BlockWorker/EE-8BitComputer/main.brd

## EAGLE design main.brd (2024-01-15)

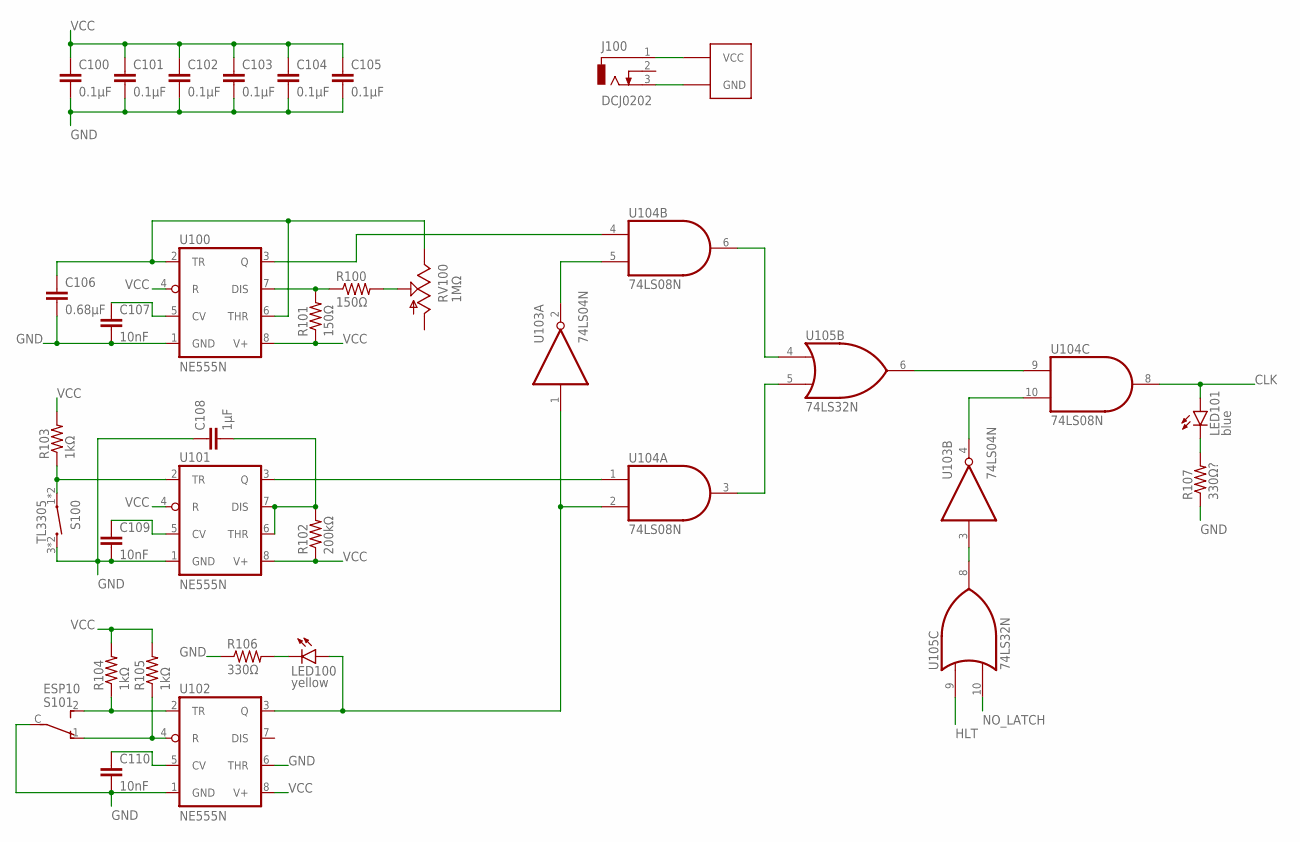
[picture p1: schematic main.sch, sheet 1, Clock & Power]

Parts:
C100, C101, C102, C103, C104, C105: 0.1µF; C0805K
C106: 0.68µF; C0805K
C107, C109, C110: 10nF; C0805K
C108: 1µF; C0805K
J100: DCJ0202
LED100: yellow; LED3MM
LED101: blue; LED3MM
R100, R101: 150Ω; R0805
R102: 200kΩ; R0805
R103, R104, R105: 1kΩ; R0805
R106: 330Ω; R0805
R107: 330Ω?; R0805
RV100: 1MΩ; CA9V
S100: TL3305; TL3305_MICROSWITCH
S101: ESP10
U100, U101, U102: NE555N; DIL08
U103: 74LS04N; DIL14
U104: 74LS08N; DIL14
U105: 74LS32N; DIL14

Connections:
!CLK_ENABLE: U103.3 (I), U105.8 (O)
!CLK_SWITCH: U103.2 (O), U104.5 (I1)
CLK: LED101.A, U104.8 (O); also elsewhere on the board
CLK_AUTO: U104.6 (O), U105.4 (I0)
CLK_AUTO_RAW: U100.3 (Q), U104.4 (I0)
CLK_ENABLE: U103.4 (O), U104.10 (I1)
CLK_MANUAL: U104.3 (O), U105.5 (I1)
CLK_MANUAL_RAW: U101.3 (Q), U104.1 (I0)
CLK_RAW: U104.9 (I0), U105.6 (O)
CLK_SWITCH: LED100.A, U102.3 (Q), U103.1 (I), U104.2 (I1)
GND: C100.2, C101.2, C102.2, C103.2, C104.2, C105.2, C106.2, C107.2, C108.1, C109.2, C110.2, J100.3, R106.1, R107.1, S100.3 (2), S100.4 (2), S101.C, U100.1 (GND), U101.1 (GND), U102.1 (GND), U102.6 (THR), U103.7 (GND), U104.7 (GND), U105.7 (GND); also elsewhere on the board
HLT: U105.9 (I0); also elsewhere on the board
LED100_GND: LED100.K (C), R106.2
LED101_GND: LED101.K (C), R107.2
NO_LATCH: U105.10 (I1); also elsewhere on the board
U100_CAP: C106.1, RV100.E, U100.2 (TR), U100.6 (THR)
U100_CV: C107.1, U100.5 (CV)
U100_DIS: R100.1, R101.2, U100.7 (DIS)
U100_DIS_INT: R100.2, RV100.S
U101_CAP: C108.2, R102.2, U101.6 (THR), U101.7 (DIS)
U101_CV: C109.1, U101.5 (CV)
U101_TR: R103.1, S100.1, S100.2 (1), U101.2 (TR)
U102_CV: C110.1, U102.5 (CV)
U102_R: R105.1, S101.1 (O), U102.4 (R)
U102_TR: R104.1, S101.2 (S), U102.2 (TR)
VCC: C100.1, C101.1, C102.1, C103.1, C104.1, C105.1, J100.1, R101.1, R102.1, R103.2, R104.2, R105.2, U100.4 (R), U100.8 (V+), U101.4 (R), U101.8 (V+), U102.8 (V+), U103.14 (VCC), U104.14 (VCC), U105.14 (VCC); also elsewhere on the board

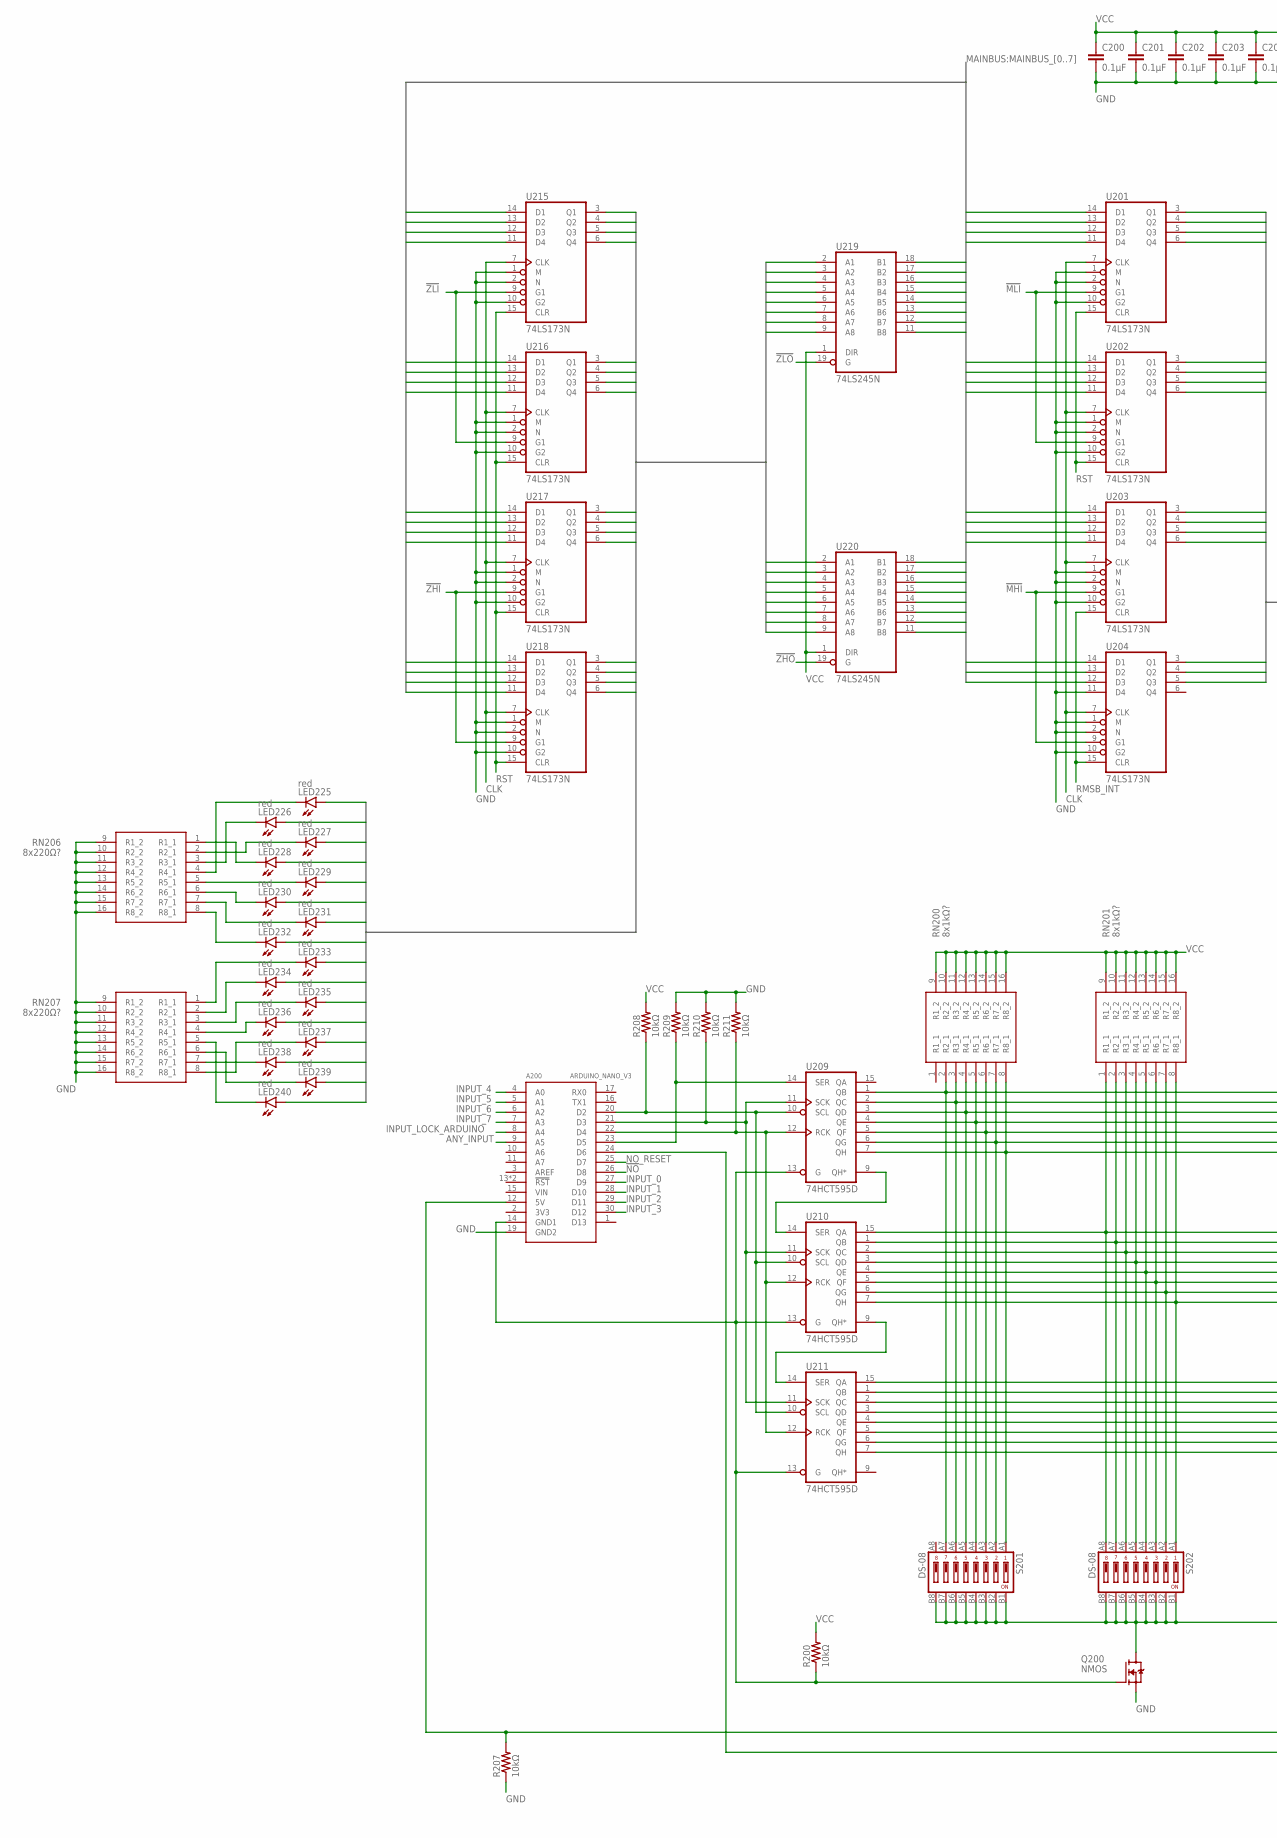
[picture p2: schematic main.sch, sheet 2, RAM & Z Register, part in row 1, column 1]

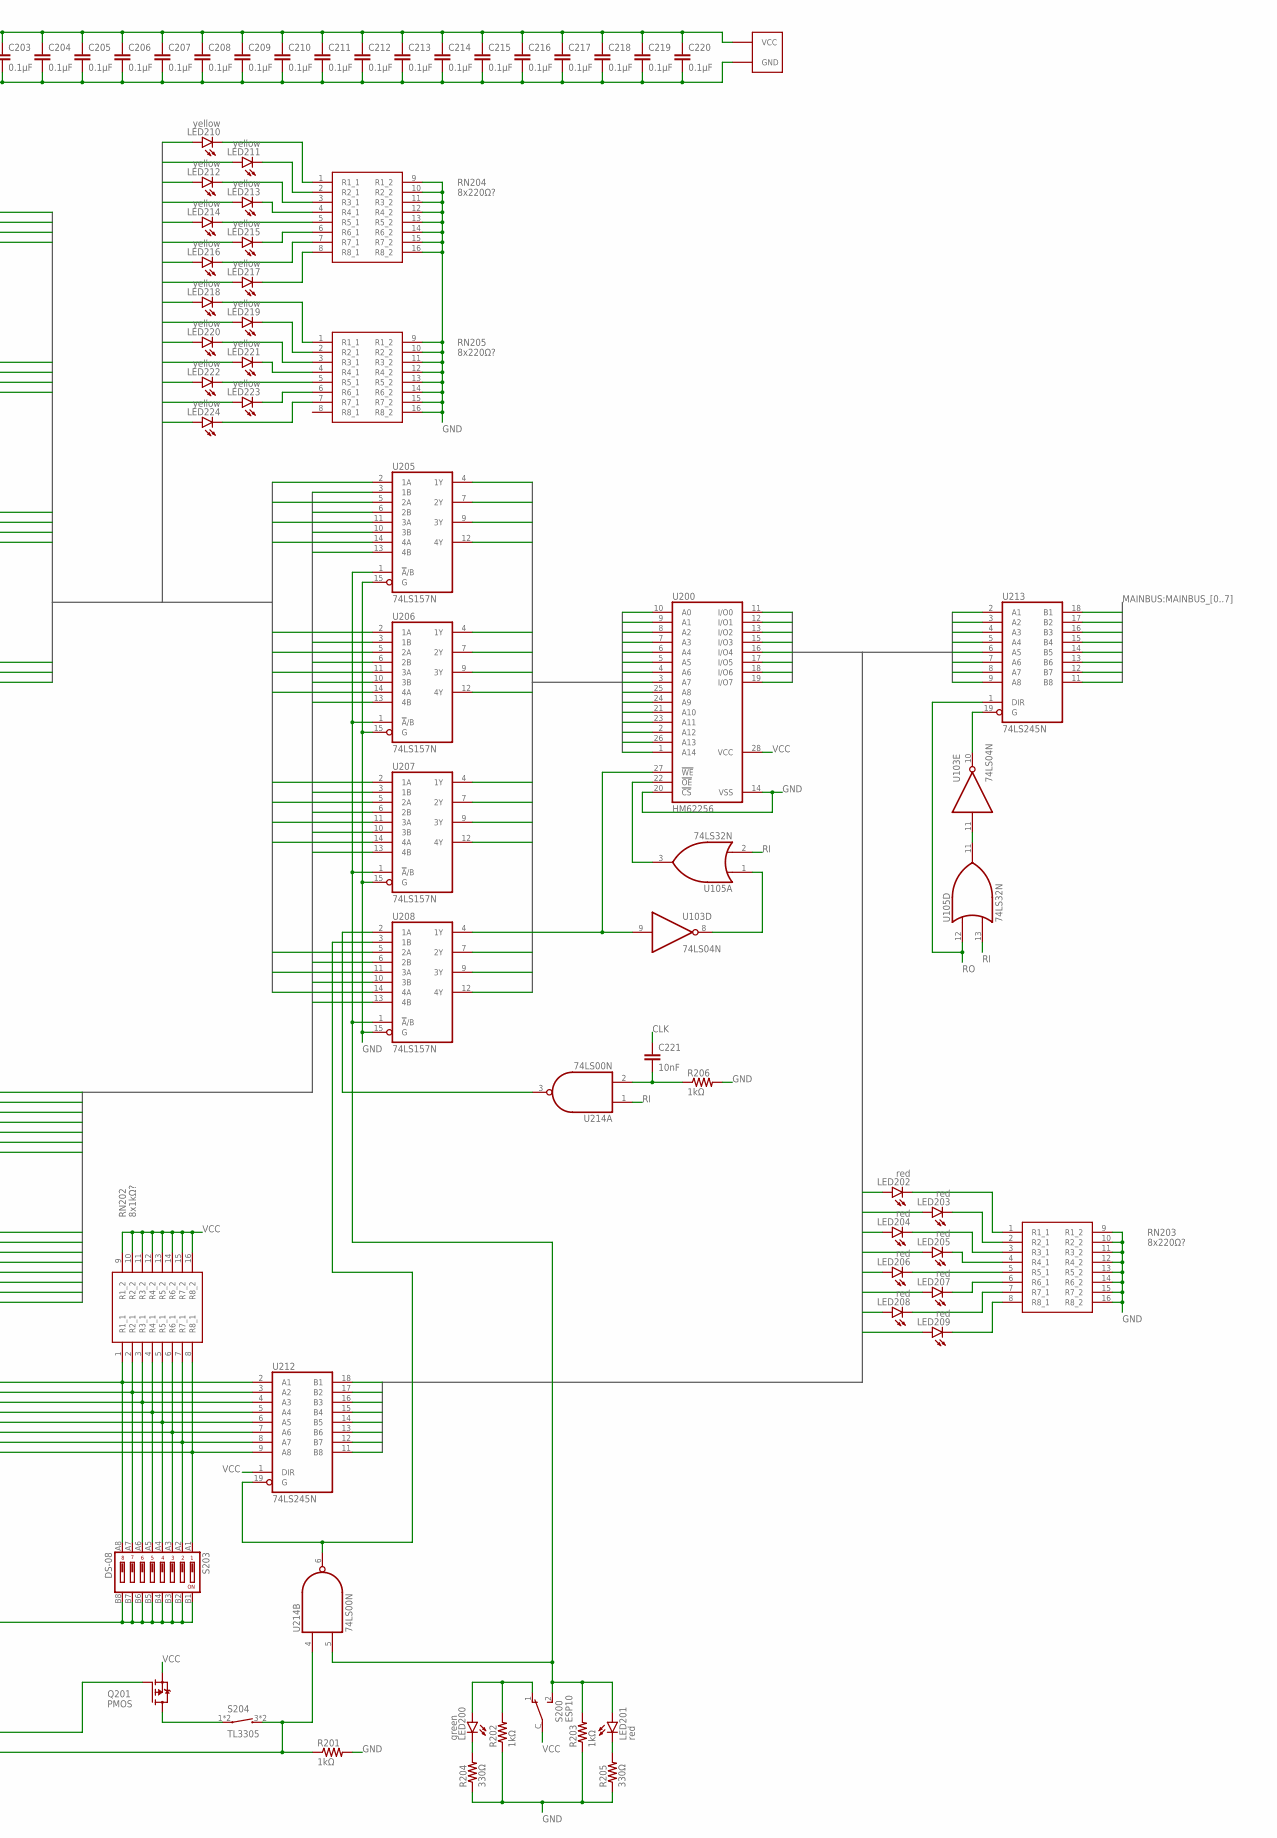
[picture p3: schematic main.sch, sheet 2, RAM & Z Register, part in row 1, column 2]

Parts:
A200: ARDUINO_NANO_V3
C200, C201, C202, C203, C204, C205, C206, C207, C208, C209, C210, C211, C212, C213, C214, C215, C216, C217, C218, C219, C220: 0.1µF; C0805K
C221: 10nF; C0805K
LED200: green; LED3MM
LED201, LED202, LED203, LED204, LED205, LED206, LED207, LED208, LED209, LED225, LED226, LED227, LED228, LED229, LED230, LED231, LED232, LED233, LED234, LED235, LED236, LED237, LED238, LED239, LED240: red; LED3MM
LED210, LED211, LED212, LED213, LED214, LED215, LED216, LED217, LED218, LED219, LED220, LED221, LED222, LED223, LED224: yellow; LED3MM
Q200: NMOS; SOT23
Q201: PMOS; SOT23
R200, R207, R208, R209, R210, R211: 10kΩ; R0805
R201, R202, R203, R206: 1kΩ; R0805
R204, R205: 330Ω; R0805
RN200, RN201, RN202: 8x1kΩ?; CAY16102J8LF
RN203, RN204, RN205, RN206, RN207: 8x220Ω?; CAY16102J8LF
S200: ESP10
S201, S202, S203: DS-08; DIPSW-08
S204: TL3305; TL3305_MICROSWITCH
U103: 74LS04N; DIL14
U105: 74LS32N; DIL14
U200: HM62256; DIL28-6
U201, U202, U203, U204, U215, U216, U217, U218: 74LS173N; DIL16
U205, U206, U207, U208: 74LS157N; DIL16
U209, U210, U211: 74HCT595D; SO16
U212, U213, U219, U220: 74LS245N; DIL20
U214: 74LS00N; DIL14

Connections:
!MEM_IO_EN: U103.10 (O), U213.19 (G)
!MEM_MANMODE: LED200.A, R202.2, S200.1 (O)
!MHI: U203.9 (G1), U204.9 (G1); also elsewhere on the board
!MLI: U201.9 (G1), U202.9 (G1); also elsewhere on the board
!NO: A200.26 (D8); also elsewhere on the board
!ZHI: U217.9 (G1), U218.9 (G1); also elsewhere on the board
!ZHO: U220.19 (G); also elsewhere on the board
!ZLI: U215.9 (G1), U216.9 (G1); also elsewhere on the board
!ZLO: U219.19 (G); also elsewhere on the board
ANY_INPUT: A200.9 (A5); also elsewhere on the board
ARDUINO_5V_SENSE: A200.12 (5V), Q201.1 (G), R207.2
ARDUINO_DETECT_GND: A200.14 (GND1), Q200.1 (G), R200.1, U209.13 (G), U210.13 (G), U211.13 (G)
ARDUINO_SR_CHAIN1: U209.9 (QH*), U210.14 (SER)
ARDUINO_SR_CHAIN2: U210.9 (QH*), U211.14 (SER)
ARDUINO_SR_CLK: A200.21 (D3), R210.1, U209.11 (SCK), U210.11 (SCK), U211.11 (SCK)
ARDUINO_SR_CLR: A200.20 (D2), R208.1, U209.10 (SCL), U210.10 (SCL), U211.10 (SCL)
ARDUINO_SR_DATA: A200.23 (D5), R209.1, U209.14 (SER)
ARDUINO_SR_PUSH: A200.22 (D4), R211.1, U209.12 (RCK), U210.12 (RCK), U211.12 (RCK)
CLK: C221.1, U201.7 (CLK), U202.7 (CLK), U203.7 (CLK), U204.7 (CLK), U215.7 (CLK), U216.7 (CLK), U217.7 (CLK), U218.7 (CLK); also elsewhere on the board
GND: A200.19 (GND2), C200.2, C201.2, C202.2, C203.2, C204.2, C205.2, C206.2, C207.2, C208.2, C209.2, C210.2, C211.2, C212.2, C213.2, C214.2, C215.2, C216.2, C217.2, C218.2, C219.2, C220.2, Q200.2 (S), R201.2, R202.1, R203.1, R204.1, R205.1, R206.2, R207.1, R209.2, R210.2, R211.2, RN203.9 (R1_2), RN203.10 (R2_2), RN203.11 (R3_2), RN203.12 (R4_2), RN203.13 (R5_2), RN203.14 (R6_2), RN203.15 (R7_2), RN203.16 (R8_2), RN204.9 (R1_2), RN204.10 (R2_2), RN204.11 (R3_2), RN204.12 (R4_2), RN204.13 (R5_2), RN204.14 (R6_2), RN204.15 (R7_2), RN204.16 (R8_2), RN205.9 (R1_2), RN205.10 (R2_2), RN205.11 (R3_2), RN205.12 (R4_2), RN205.13 (R5_2), RN205.14 (R6_2), RN205.15 (R7_2), RN205.16 (R8_2), RN206.9 (R1_2), RN206.10 (R2_2), RN206.11 (R3_2), RN206.12 (R4_2), RN206.13 (R5_2), RN206.14 (R6_2), RN206.15 (R7_2), RN206.16 (R8_2), RN207.9 (R1_2), RN207.10 (R2_2), RN207.11 (R3_2), RN207.12 (R4_2), RN207.13 (R5_2), RN207.14 (R6_2), RN207.15 (R7_2), RN207.16 (R8_2), U103.7 (GND), U105.7 (GND), U200.14 (VSS), U200.20 (!CS), U201.1 (M), U201.2 (N), U201.8 (GND), U201.10 (G2), U202.1 (M), U202.2 (N), U202.8 (GND), U202.10 (G2), U203.1 (M), U203.2 (N), U203.8 (GND), U203.10 (G2), U204.1 (M), U204.2 (N), U204.8 (GND), U204.10 (G2), U204.11 (D4), U205.8 (GND), U205.15 (G), U206.8 (GND), U206.15 (G), U207.8 (GND), U207.15 (G), U208.8 (GND), U208.15 (G), U209.8 (GND), U210.8 (GND), U211.8 (GND), U212.10 (GND), U213.10 (GND), U214.7 (GND), U215.1 (M), U215.2 (N), U215.8 (GND), U215.10 (G2), U216.1 (M), U216.2 (N), U216.8 (GND), U216.10 (G2), U217.1 (M), U217.2 (N), U217.8 (GND), U217.10 (G2), U218.1 (M), U218.2 (N), U218.8 (GND), U218.10 (G2), U219.10 (GND), U220.10 (GND); also elsewhere on the board
INPUT_0: A200.27 (D9); also elsewhere on the board
INPUT_1: A200.28 (D10); also elsewhere on the board
INPUT_2: A200.29 (D11); also elsewhere on the board
INPUT_3: A200.30 (D12); also elsewhere on the board
INPUT_4: A200.4 (A0); also elsewhere on the board
INPUT_5: A200.5 (A1); also elsewhere on the board
INPUT_6: A200.6 (A2); also elsewhere on the board
INPUT_7: A200.7 (A3); also elsewhere on the board
INPUT_LOCK_ARDUINO: A200.8 (A4); also elsewhere on the board
LED202_GND: LED202.K (C), RN203.1 (R1_1)
LED203_GND: LED203.K (C), RN203.2 (R2_1)
LED204_GND: LED204.K (C), RN203.3 (R3_1)
LED205_GND: LED205.K (C), RN203.4 (R4_1)
LED206_GND: LED206.K (C), RN203.5 (R5_1)
LED207_GND: LED207.K (C), RN203.6 (R6_1)
LED208_GND: LED208.K (C), RN203.7 (R7_1)
LED209_GND: LED209.K (C), RN203.8 (R8_1)
LED210_GND: LED210.K (C), RN204.1 (R1_1)
LED211_GND: LED211.K (C), RN204.2 (R2_1)
LED212_GND: LED212.K (C), RN204.3 (R3_1)
LED213_GND: LED213.K (C), RN204.4 (R4_1)
LED214_GND: LED214.K (C), RN204.5 (R5_1)
LED215_GND: LED215.K (C), RN204.6 (R6_1)
LED216_GND: LED216.K (C), RN204.7 (R7_1)
LED217_GND: LED217.K (C), RN204.8 (R8_1)
LED218_GND: LED218.K (C), RN205.1 (R1_1)
LED219_GND: LED219.K (C), RN205.2 (R2_1)
LED220_GND: LED220.K (C), RN205.3 (R3_1)
LED221_GND: LED221.K (C), RN205.4 (R4_1)
LED222_GND: LED222.K (C), RN205.5 (R5_1)
LED223_GND: LED223.K (C), RN205.6 (R6_1)
LED224_GND: LED224.K (C), RN205.7 (R7_1)
LED225_GND: LED225.K (C), RN206.4 (R4_1)
LED226_GND: LED226.K (C), RN206.3 (R3_1)
LED227_GND: LED227.K (C), RN206.2 (R2_1)
LED228_GND: LED228.K (C), RN206.1 (R1_1)
LED229_GND: LED229.K (C), RN206.5 (R5_1)
LED230_GND: LED230.K (C), RN206.6 (R6_1)
LED231_GND: LED231.K (C), RN206.7 (R7_1)
LED232_GND: LED232.K (C), RN206.8 (R8_1)
LED233_GND: LED233.K (C), RN207.1 (R1_1)
LED234_GND: LED234.K (C), RN207.2 (R2_1)
LED235_GND: LED235.K (C), RN207.3 (R3_1)
LED236_GND: LED236.K (C), RN207.4 (R4_1)
LED237_GND: LED237.K (C), RN207.8 (R8_1)
LED238_GND: LED238.K (C), RN207.7 (R7_1)
LED239_GND: LED239.K (C), RN207.6 (R6_1)
LED240_GND: LED240.K (C), RN207.5 (R5_1)
MAINBUS_0: U201.14 (D1), U203.14 (D1), U213.18 (B1), U215.14 (D1), U217.14 (D1), U219.18 (B1), U220.18 (B1); also elsewhere on the board
MAINBUS_1: U201.13 (D2), U203.13 (D2), U213.17 (B2), U215.13 (D2), U217.13 (D2), U219.17 (B2), U220.17 (B2); also elsewhere on the board
MAINBUS_2: U201.12 (D3), U203.12 (D3), U213.16 (B3), U215.12 (D3), U217.12 (D3), U219.16 (B3), U220.16 (B3); also elsewhere on the board
MAINBUS_3: U201.11 (D4), U203.11 (D4), U213.15 (B4), U215.11 (D4), U217.11 (D4), U219.15 (B4), U220.15 (B4); also elsewhere on the board
MAINBUS_4: U202.14 (D1), U204.14 (D1), U213.14 (B5), U216.14 (D1), U218.14 (D1), U219.14 (B5), U220.14 (B5); also elsewhere on the board
MAINBUS_5: U202.13 (D2), U204.13 (D2), U213.13 (B6), U216.13 (D2), U218.13 (D2), U219.13 (B6), U220.13 (B6); also elsewhere on the board
MAINBUS_6: U202.12 (D3), U204.12 (D3), U213.12 (B7), U216.12 (D3), U218.12 (D3), U219.12 (B7), U220.12 (B7); also elsewhere on the board
MAINBUS_7: U202.11 (D4), U213.11 (B8), U216.11 (D4), U218.11 (D4), U219.11 (B8), U220.11 (B8); also elsewhere on the board
MEMADDR_0: U200.10 (A0), U205.4 (1Y)
MEMADDR_1: U200.9 (A1), U205.7 (2Y)
MEMADDR_2: U200.8 (A2), U205.12 (4Y)
MEMADDR_3: U200.7 (A3), U205.9 (3Y)
MEMADDR_4: U200.6 (A4), U206.7 (2Y)
MEMADDR_5: U200.5 (A5), U206.4 (1Y)
MEMADDR_6: U200.4 (A6), U206.9 (3Y)
MEMADDR_7: U200.3 (A7), U206.12 (4Y)
MEMADDR_8: U200.25 (A8), U207.7 (2Y)
MEMADDR_9: U200.24 (A9), U207.4 (1Y)
MEMADDR_10: U200.21 (A10), U207.12 (4Y)
MEMADDR_11: U200.23 (A11), U207.9 (3Y)
MEMADDR_12: U200.2 (A12), U208.12 (4Y)
MEMADDR_13: U200.26 (A13), U208.7 (2Y)
MEMADDR_14: U200.1 (A14), U208.9 (3Y)
MEMADDR_AUTO_0: LED210.A, U201.3 (Q1), U205.2 (1A)
MEMADDR_AUTO_1: LED211.A, U201.4 (Q2), U205.5 (2A)
MEMADDR_AUTO_2: LED212.A, U201.5 (Q3), U205.14 (4A)
MEMADDR_AUTO_3: LED213.A, U201.6 (Q4), U205.11 (3A)
MEMADDR_AUTO_4: LED214.A, U202.3 (Q1), U206.5 (2A)
MEMADDR_AUTO_5: LED215.A, U202.4 (Q2), U206.2 (1A)
MEMADDR_AUTO_6: LED216.A, U202.5 (Q3), U206.11 (3A)
MEMADDR_AUTO_7: LED217.A, U202.6 (Q4), U206.14 (4A)
MEMADDR_AUTO_8: LED218.A, U203.3 (Q1), U207.5 (2A)
MEMADDR_AUTO_9: LED219.A, U203.4 (Q2), U207.2 (1A)
MEMADDR_AUTO_10: LED220.A, U203.5 (Q3), U207.14 (4A)
MEMADDR_AUTO_11: LED221.A, U203.6 (Q4), U207.11 (3A)
MEMADDR_AUTO_12: LED222.A, U204.3 (Q1), U208.14 (4A)
MEMADDR_AUTO_13: LED223.A, U204.4 (Q2), U208.5 (2A)
MEMADDR_AUTO_14: LED224.A, U204.5 (Q3), U208.11 (3A)
MEMADDR_MAN_0: RN201.8 (R8_1), S202.A1 (1), U205.3 (1B), U210.7 (QH)
MEMADDR_MAN_1: RN201.7 (R7_1), S202.A2 (2), U205.6 (2B), U210.6 (QG)
MEMADDR_MAN_2: RN201.6 (R6_1), S202.A3 (3), U205.13 (4B), U210.5 (QF)
MEMADDR_MAN_3: RN201.5 (R5_1), S202.A4 (4), U205.10 (3B), U210.4 (QE)
MEMADDR_MAN_4: RN201.4 (R4_1), S202.A5 (5), U206.6 (2B), U210.3 (QD)
MEMADDR_MAN_5: RN201.3 (R3_1), S202.A6 (6), U206.3 (1B), U210.2 (QC)
MEMADDR_MAN_6: RN201.2 (R2_1), S202.A7 (7), U206.10 (3B), U210.1 (QB)
MEMADDR_MAN_7: RN201.1 (R1_1), S202.A8 (8), U206.13 (4B), U210.15 (QA)
MEMADDR_MAN_8: RN200.8 (R8_1), S201.A1 (1), U207.6 (2B), U209.7 (QH)
MEMADDR_MAN_9: RN200.7 (R7_1), S201.A2 (2), U207.3 (1B), U209.6 (QG)
MEMADDR_MAN_10: RN200.6 (R6_1), S201.A3 (3), U207.13 (4B), U209.5 (QF)
MEMADDR_MAN_11: RN200.5 (R5_1), S201.A4 (4), U207.10 (3B), U209.4 (QE)
MEMADDR_MAN_12: RN200.4 (R4_1), S201.A5 (5), U208.13 (4B), U209.3 (QD)
MEMADDR_MAN_13: RN200.3 (R3_1), S201.A6 (6), U208.6 (2B), U209.2 (QC)
MEMADDR_MAN_14: RN200.2 (R2_1), S201.A7 (7), U208.10 (3B), U209.1 (QB)
MEMIO_0: LED202.A, U200.11 (I/O0), U212.11 (B8), U213.2 (A1)
MEMIO_1: LED203.A, U200.12 (I/O1), U212.12 (B7), U213.3 (A2)
MEMIO_2: LED204.A, U200.13 (I/O2), U212.13 (B6), U213.4 (A3)
MEMIO_3: LED205.A, U200.15 (I/O3), U212.14 (B5), U213.5 (A4)
MEMIO_4: LED206.A, U200.16 (I/O4), U212.15 (B4), U213.6 (A5)
MEMIO_5: LED207.A, U200.17 (I/O5), U212.16 (B3), U213.7 (A6)
MEMIO_6: LED208.A, U200.18 (I/O6), U212.17 (B2), U213.8 (A7)
MEMIO_7: LED209.A, U200.19 (I/O7), U212.18 (B1), U213.9 (A8)
MEMIO_MAN_0: RN202.8 (R8_1), S203.A1 (1), U211.7 (QH), U212.9 (A8)
MEMIO_MAN_1: RN202.7 (R7_1), S203.A2 (2), U211.6 (QG), U212.8 (A7)
MEMIO_MAN_2: RN202.6 (R6_1), S203.A3 (3), U211.5 (QF), U212.7 (A6)
MEMIO_MAN_3: RN202.5 (R5_1), S203.A4 (4), U211.4 (QE), U212.6 (A5)
MEMIO_MAN_4: RN202.4 (R4_1), S203.A5 (5), U211.3 (QD), U212.5 (A4)
MEMIO_MAN_5: RN202.3 (R3_1), S203.A6 (6), U211.2 (QC), U212.4 (A3)
MEMIO_MAN_6: RN202.2 (R2_1), S203.A7 (7), U211.1 (QB), U212.3 (A2)
MEMIO_MAN_7: RN202.1 (R1_1), S203.A8 (8), U211.15 (QA), U212.2 (A1)
MEM_!MANMODE!_LED: LED200.K (C), R204.2
MEM_!OE: U105.3 (O), U200.22 (!OE)
MEM_!OE_INT: U103.8 (O), U105.1 (I0)
MEM_!WE: U103.9 (I), U200.27 (!WE), U208.4 (1Y)
MEM_!WE!_AUTO: U208.2 (1A), U214.3 (O)
MEM_!WE!_MAN: U208.3 (1B), U212.19 (G), U214.6 (O)
MEM_CLK_PULSE: C221.2, R206.1, U214.2 (I1)
MEM_IO_EN: U103.11 (I), U105.11 (O)
MEM_MANMODE: LED201.A, R203.2, S200.2 (S), U205.1 (!A!/B), U206.1 (!A!/B), U207.1 (!A!/B), U208.1 (!A!/B), U214.5 (I1)
MEM_MANMODE_LED: LED201.K (C), R205.2
MEM_MAN_GND: Q200.3 (D), S201.B1 (16), S201.B2 (15), S201.B3 (14), S201.B4 (13), S201.B5 (12), S201.B6 (11), S201.B7 (10), S201.B8 (9), S202.B1 (16), S202.B2 (15), S202.B3 (14), S202.B4 (13), S202.B5 (12), S202.B6 (11), S202.B7 (10), S202.B8 (9), S203.B1 (16), S203.B2 (15), S203.B3 (14), S203.B4 (13), S203.B5 (12), S203.B6 (11), S203.B7 (10), S203.B8 (9)
MEM_MAN_VCC: Q201.3 (D), S204.1, S204.2 (1)
MEM_MAN_WRITE: A200.24 (D6), R201.1, S204.3 (2), S204.4 (2), U214.4 (I0)
NO_RESET: A200.25 (D7); also elsewhere on the board
REG_Z_0: LED225.A, U215.3 (Q1), U219.2 (A1)
REG_Z_1: LED226.A, U215.4 (Q2), U219.3 (A2)
REG_Z_2: LED227.A, U215.5 (Q3), U219.4 (A3)
REG_Z_3: LED228.A, U215.6 (Q4), U219.5 (A4)
REG_Z_4: LED229.A, U216.3 (Q1), U219.6 (A5)
REG_Z_5: LED230.A, U216.4 (Q2), U219.7 (A6)
REG_Z_6: LED231.A, U216.5 (Q3), U219.8 (A7)
REG_Z_7: LED232.A, U216.6 (Q4), U219.9 (A8)
REG_Z_8: LED233.A, U217.3 (Q1), U220.2 (A1)
REG_Z_9: LED234.A, U217.4 (Q2), U220.3 (A2)
REG_Z_10: LED235.A, U217.5 (Q3), U220.4 (A3)
REG_Z_11: LED236.A, U217.6 (Q4), U220.5 (A4)
REG_Z_12: LED237.A, U218.3 (Q1), U220.6 (A5)
REG_Z_13: LED238.A, U218.4 (Q2), U220.7 (A6)
REG_Z_14: LED239.A, U218.5 (Q3), U220.8 (A7)
REG_Z_15: LED240.A, U218.6 (Q4), U220.9 (A8)
RI: U105.2 (I1), U105.13 (I1), U214.1 (I0); also elsewhere on the board
RMSB_INT: U203.15 (CLR), U204.15 (CLR); also elsewhere on the board
RO: U105.12 (I0), U213.1 (DIR); also elsewhere on the board
RST: U201.15 (CLR), U202.15 (CLR), U215.15 (CLR), U216.15 (CLR), U217.15 (CLR), U218.15 (CLR); also elsewhere on the board
VCC: C200.1, C201.1, C202.1, C203.1, C204.1, C205.1, C206.1, C207.1, C208.1, C209.1, C210.1, C211.1, C212.1, C213.1, C214.1, C215.1, C216.1, C217.1, C218.1, C219.1, C220.1, Q201.2 (S), R200.2, R208.2, RN200.9 (R1_2), RN200.10 (R2_2), RN200.11 (R3_2), RN200.12 (R4_2), RN200.13 (R5_2), RN200.14 (R6_2), RN200.15 (R7_2), RN200.16 (R8_2), RN201.9 (R1_2), RN201.10 (R2_2), RN201.11 (R3_2), RN201.12 (R4_2), RN201.13 (R5_2), RN201.14 (R6_2), RN201.15 (R7_2), RN201.16 (R8_2), RN202.9 (R1_2), RN202.10 (R2_2), RN202.11 (R3_2), RN202.12 (R4_2), RN202.13 (R5_2), RN202.14 (R6_2), RN202.15 (R7_2), RN202.16 (R8_2), S200.C, U103.14 (VCC), U105.14 (VCC), U200.28 (VCC), U201.16 (VCC), U202.16 (VCC), U203.16 (VCC), U204.16 (VCC), U205.16 (VCC), U206.16 (VCC), U207.16 (VCC), U208.16 (VCC), U209.16 (VCC), U210.16 (VCC), U211.16 (VCC), U212.1 (DIR), U212.20 (VCC), U213.20 (VCC), U214.14 (VCC), U215.16 (VCC), U216.16 (VCC), U217.16 (VCC), U218.16 (VCC), U219.1 (DIR), U219.20 (VCC), U220.1 (DIR), U220.20 (VCC); also elsewhere on the board

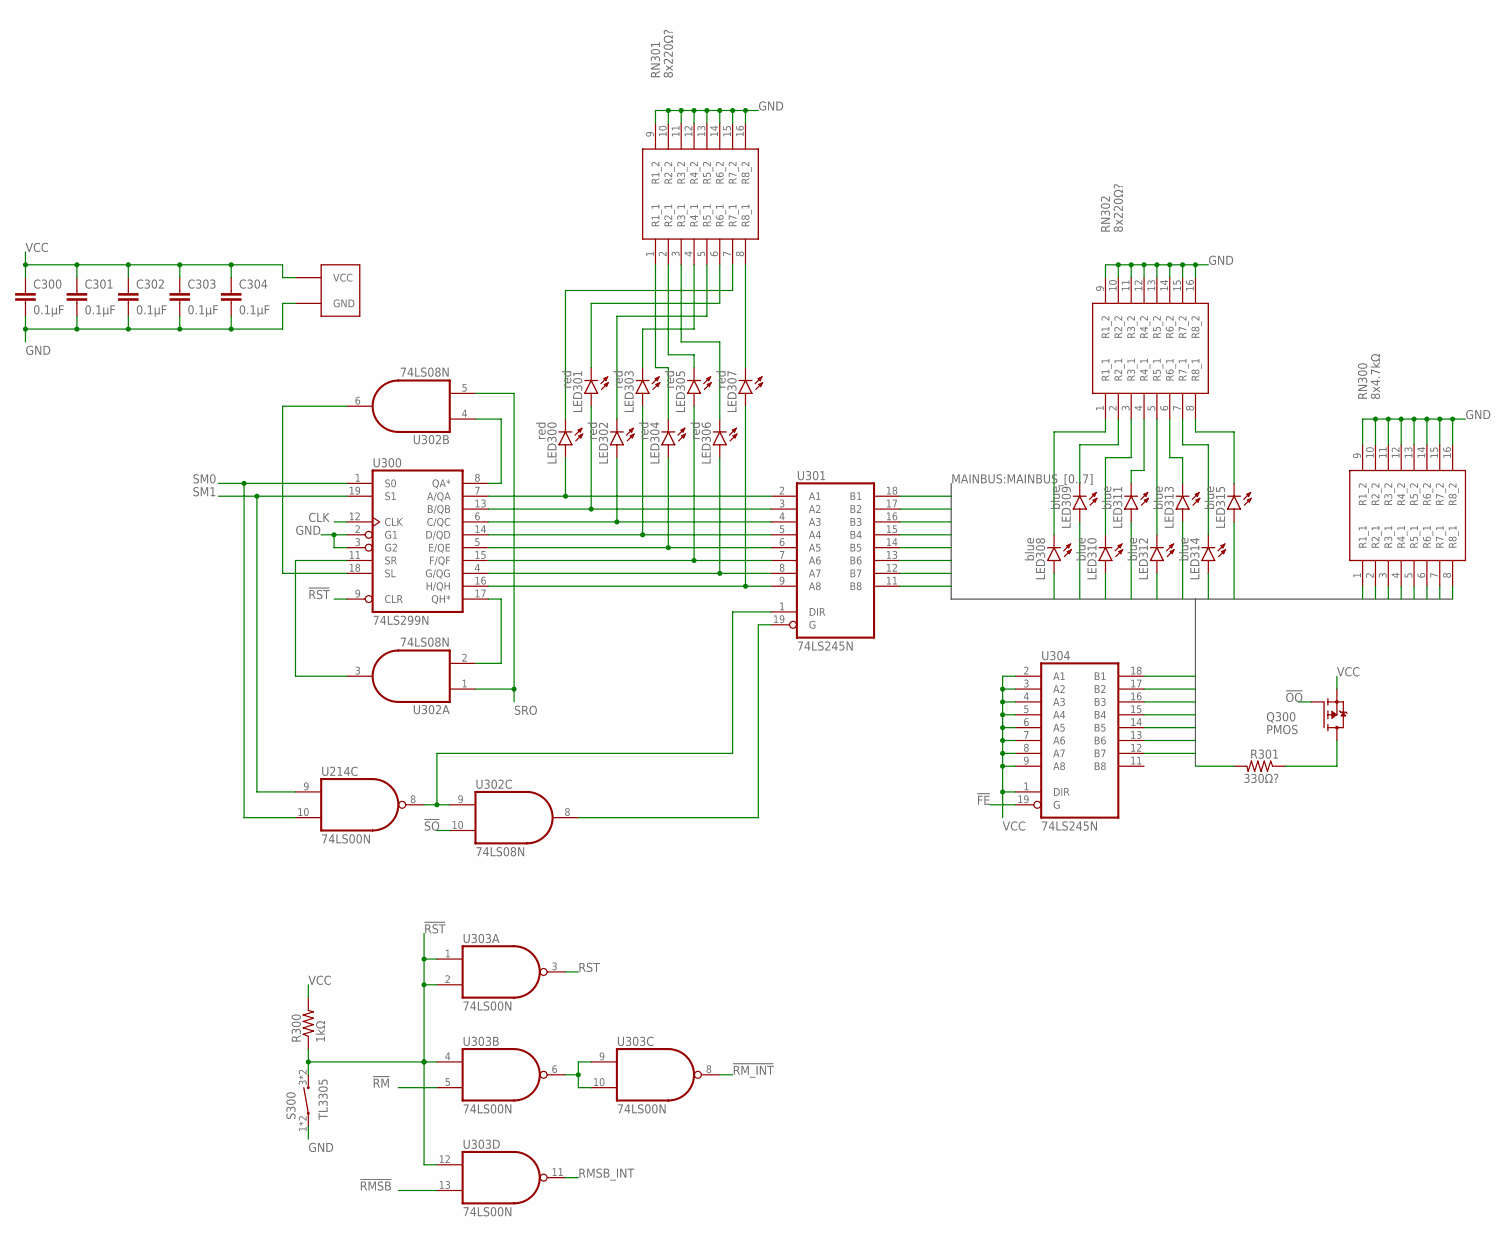
[picture p4: schematic main.sch, sheet 3, Shift Register, Bus & Reset]

Parts:
C300, C301, C302, C303, C304: 0.1µF; C0805K
LED300, LED301, LED302, LED303, LED304, LED305, LED306, LED307: red; LED3MM
LED308, LED309, LED310, LED311, LED312, LED313, LED314, LED315: blue; LED3MM
Q300: PMOS; SOT23
R300: 1kΩ; R0805
R301: 330Ω?; R0805
RN300: 8x4.7kΩ; CAY16102J8LF
RN301, RN302: 8x220Ω?; CAY16102J8LF
S300: TL3305; TL3305_MICROSWITCH
U214, U303: 74LS00N; DIL14
U300: 74LS299N; DIL20
U301, U304: 74LS245N; DIL20
U302: 74LS08N; DIL14

Connections:
!FE: U304.19 (G); also elsewhere on the board
!OO: Q300.1 (G); also elsewhere on the board
!RM: U303.5 (I1); also elsewhere on the board
!RMSB: U303.13 (I1); also elsewhere on the board
!RM_INT: U303.8 (O); also elsewhere on the board
!RST: R300.1, S300.3 (2), S300.4 (2), U300.9 (CLR), U303.1 (I0), U303.2 (I1), U303.4 (I0), U303.12 (I0); also elsewhere on the board
!SHIFT_IO_EN: U301.19 (G), U302.8 (O)
!SO: U302.10 (I1); also elsewhere on the board
BUS_OO: Q300.3 (D), R301.1
CLK: U300.12 (CLK); also elsewhere on the board
GND: C300.2, C301.2, C302.2, C303.2, C304.2, RN300.9 (R1_2), RN300.10 (R2_2), RN300.11 (R3_2), RN300.12 (R4_2), RN300.13 (R5_2), RN300.14 (R6_2), RN300.15 (R7_2), RN300.16 (R8_2), RN301.9 (R1_2), RN301.10 (R2_2), RN301.11 (R3_2), RN301.12 (R4_2), RN301.13 (R5_2), RN301.14 (R6_2), RN301.15 (R7_2), RN301.16 (R8_2), RN302.9 (R1_2), RN302.10 (R2_2), RN302.11 (R3_2), RN302.12 (R4_2), RN302.13 (R5_2), RN302.14 (R6_2), RN302.15 (R7_2), RN302.16 (R8_2), S300.1, S300.2 (1), U214.7 (GND), U300.2 (G1), U300.3 (G2), U300.10 (GND), U301.10 (GND), U302.7 (GND), U303.7 (GND), U304.10 (GND); also elsewhere on the board
LED300_GND: LED300.K (C), RN301.7 (R7_1)
LED301_GND: LED301.K (C), RN301.6 (R6_1)
LED302_GND: LED302.K (C), RN301.5 (R5_1)
LED303_GND: LED303.K (C), RN301.4 (R4_1)
LED304_GND: LED304.K (C), RN301.1 (R1_1)
LED305_GND: LED305.K (C), RN301.2 (R2_1)
LED306_GND: LED306.K (C), RN301.3 (R3_1)
LED307_GND: LED307.K (C), RN301.8 (R8_1)
LED308_GND: LED308.K (C), RN302.1 (R1_1)
LED309_GND: LED309.K (C), RN302.2 (R2_1)
LED310_GND: LED310.K (C), RN302.3 (R3_1)
LED311_GND: LED311.K (C), RN302.4 (R4_1)
LED312_GND: LED312.K (C), RN302.5 (R5_1)
LED313_GND: LED313.K (C), RN302.6 (R6_1)
LED314_GND: LED314.K (C), RN302.7 (R7_1)
LED315_GND: LED315.K (C), RN302.8 (R8_1)
MAINBUS_0: LED315.A, R301.2, RN300.8 (R8_1), U301.11 (B8); also elsewhere on the board
MAINBUS_1: LED314.A, RN300.7 (R7_1), U301.12 (B7), U304.12 (B7); also elsewhere on the board
MAINBUS_2: LED313.A, RN300.6 (R6_1), U301.13 (B6), U304.13 (B6); also elsewhere on the board
MAINBUS_3: LED312.A, RN300.5 (R5_1), U301.14 (B5), U304.14 (B5); also elsewhere on the board
MAINBUS_4: LED311.A, RN300.4 (R4_1), U301.15 (B4), U304.15 (B4); also elsewhere on the board
MAINBUS_5: LED310.A, RN300.3 (R3_1), U301.16 (B3), U304.16 (B3); also elsewhere on the board
MAINBUS_6: LED309.A, RN300.2 (R2_1), U301.17 (B2), U304.17 (B2); also elsewhere on the board
MAINBUS_7: LED308.A, RN300.1 (R1_1), U301.18 (B1), U304.18 (B1); also elsewhere on the board
RMSB_INT: U303.11 (O); also elsewhere on the board
RM_INT: U303.6 (O), U303.9 (I0), U303.10 (I1)
RST: U303.3 (O); also elsewhere on the board
SHIFT_IO_0: LED307.A, U300.16 (H/QH), U301.9 (A8)
SHIFT_IO_1: LED306.A, U300.4 (G/QG), U301.8 (A7)
SHIFT_IO_2: LED305.A, U300.15 (F/QF), U301.7 (A6)
SHIFT_IO_3: LED304.A, U300.5 (E/QE), U301.6 (A5)
SHIFT_IO_4: LED303.A, U300.14 (D/QD), U301.5 (A4)
SHIFT_IO_5: LED302.A, U300.6 (C/QC), U301.4 (A3)
SHIFT_IO_6: LED301.A, U300.13 (B/QB), U301.3 (A2)
SHIFT_IO_7: LED300.A, U300.7 (A/QA), U301.2 (A1)
SHIFT_IO_DIR: U214.8 (O), U301.1 (DIR), U302.9 (I0)
SHIFT_LEFT_FEEDBACK: U300.18 (SL), U302.6 (O)
SHIFT_LEFT_FEEDBACK_RAW: U300.8 (QA*), U302.4 (I0)
SHIFT_RIGHT_FEEDBACK: U300.11 (SR), U302.3 (O)
SHIFT_RIGHT_FEEDBACK_RAW: U300.17 (QH*), U302.2 (I1)
SM0: U214.10 (I1), U300.1 (S0); also elsewhere on the board
SM1: U214.9 (I0), U300.19 (S1); also elsewhere on the board
SRO: U302.1 (I0), U302.5 (I1); also elsewhere on the board
VCC: C300.1, C301.1, C302.1, C303.1, C304.1, Q300.2 (S), R300.2, U214.14 (VCC), U300.20 (VCC), U301.20 (VCC), U302.14 (VCC), U303.14 (VCC), U304.1 (DIR), U304.2 (A1), U304.3 (A2), U304.4 (A3), U304.5 (A4), U304.6 (A5), U304.7 (A6), U304.8 (A7), U304.9 (A8), U304.20 (VCC); also elsewhere on the board

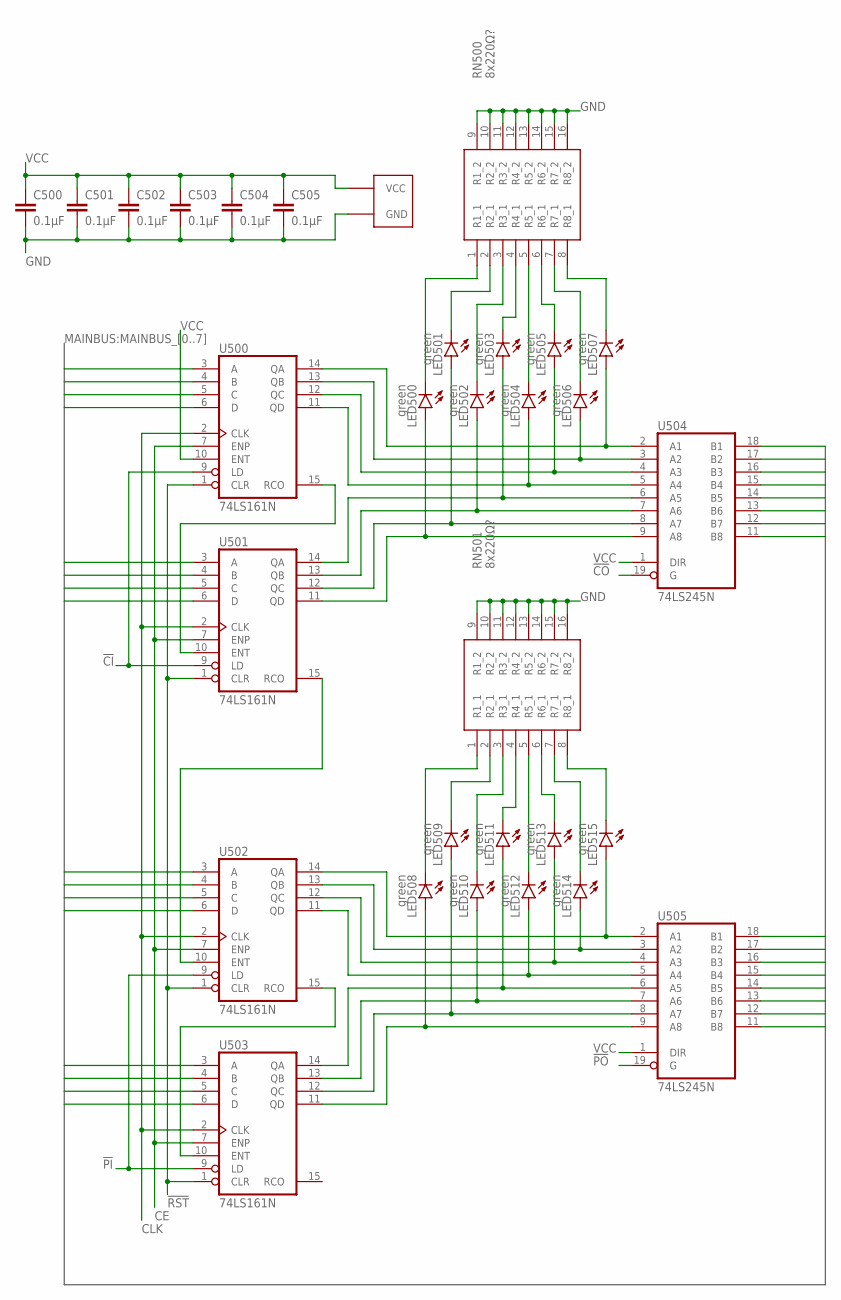
[picture p5: schematic main.sch, sheet 4, Program Counter]

Parts:
C500, C501, C502, C503, C504, C505: 0.1µF; C0805K
LED500, LED501, LED502, LED503, LED504, LED505, LED506, LED507, LED508, LED509, LED510, LED511, LED512, LED513, LED514, LED515: green; LED3MM
RN500, RN501: 8x220Ω?; CAY16102J8LF
U500, U501, U502, U503: 74LS161N; DIL16
U504, U505: 74LS245N; DIL20

Connections:
!CI: U500.9 (LD), U501.9 (LD); also elsewhere on the board
!CO: U504.19 (G); also elsewhere on the board
!PI: U502.9 (LD), U503.9 (LD); also elsewhere on the board
!PO: U505.19 (G); also elsewhere on the board
!RST: U500.1 (CLR), U501.1 (CLR), U502.1 (CLR), U503.1 (CLR); also elsewhere on the board
CE: U500.7 (ENP), U501.7 (ENP), U502.7 (ENP), U503.7 (ENP); also elsewhere on the board
CLK: U500.2 (CLK), U501.2 (CLK), U502.2 (CLK), U503.2 (CLK); also elsewhere on the board
COUNTER_0: LED507.A, U500.14 (QA), U504.2 (A1)
COUNTER_1: LED506.A, U500.13 (QB), U504.3 (A2)
COUNTER_2: LED505.A, U500.12 (QC), U504.4 (A3)
COUNTER_3: LED504.A, U500.11 (QD), U504.5 (A4)
COUNTER_4: LED503.A, U501.14 (QA), U504.6 (A5)
COUNTER_5: LED502.A, U501.13 (QB), U504.7 (A6)
COUNTER_6: LED501.A, U501.12 (QC), U504.8 (A7)
COUNTER_7: LED500.A, U501.11 (QD), U504.9 (A8)
COUNTER_RIPPLE_1: U500.15 (RCO), U501.10 (ENT)
COUNTER_RIPPLE_2: U501.15 (RCO), U502.10 (ENT)
COUNTER_RIPPLE_3: U502.15 (RCO), U503.10 (ENT)
GND: C500.2, C501.2, C502.2, C503.2, C504.2, C505.2, RN500.9 (R1_2), RN500.10 (R2_2), RN500.11 (R3_2), RN500.12 (R4_2), RN500.13 (R5_2), RN500.14 (R6_2), RN500.15 (R7_2), RN500.16 (R8_2), RN501.9 (R1_2), RN501.10 (R2_2), RN501.11 (R3_2), RN501.12 (R4_2), RN501.13 (R5_2), RN501.14 (R6_2), RN501.15 (R7_2), RN501.16 (R8_2), U500.8 (GND), U501.8 (GND), U502.8 (GND), U503.8 (GND), U504.10 (GND), U505.10 (GND); also elsewhere on the board
LED500_GND: LED500.K (C), RN500.1 (R1_1)
LED501_GND: LED501.K (C), RN500.2 (R2_1)
LED502_GND: LED502.K (C), RN500.3 (R3_1)
LED503_GND: LED503.K (C), RN500.4 (R4_1)
LED504_GND: LED504.K (C), RN500.5 (R5_1)
LED505_GND: LED505.K (C), RN500.6 (R6_1)
LED506_GND: LED506.K (C), RN500.7 (R7_1)
LED507_GND: LED507.K (C), RN500.8 (R8_1)
LED508_GND: LED508.K (C), RN501.1 (R1_1)
LED509_GND: LED509.K (C), RN501.2 (R2_1)
LED510_GND: LED510.K (C), RN501.3 (R3_1)
LED511_GND: LED511.K (C), RN501.4 (R4_1)
LED512_GND: LED512.K (C), RN501.5 (R5_1)
LED513_GND: LED513.K (C), RN501.6 (R6_1)
LED514_GND: LED514.K (C), RN501.7 (R7_1)
LED515_GND: LED515.K (C), RN501.8 (R8_1)
MAINBUS_0: U500.3 (A), U502.3 (A), U504.18 (B1), U505.18 (B1); also elsewhere on the board
MAINBUS_1: U500.4 (B), U502.4 (B), U504.17 (B2), U505.17 (B2); also elsewhere on the board
MAINBUS_2: U500.5 (C), U502.5 (C), U504.16 (B3), U505.16 (B3); also elsewhere on the board
MAINBUS_3: U500.6 (D), U502.6 (D), U504.15 (B4), U505.15 (B4); also elsewhere on the board
MAINBUS_4: U501.3 (A), U503.3 (A), U504.14 (B5), U505.14 (B5); also elsewhere on the board
MAINBUS_5: U501.4 (B), U503.4 (B), U504.13 (B6), U505.13 (B6); also elsewhere on the board
MAINBUS_6: U501.5 (C), U503.5 (C), U504.12 (B7), U505.12 (B7); also elsewhere on the board
MAINBUS_7: U501.6 (D), U503.6 (D), U504.11 (B8), U505.11 (B8); also elsewhere on the board
PAGE_0: LED515.A, U502.14 (QA), U505.2 (A1)
PAGE_1: LED514.A, U502.13 (QB), U505.3 (A2)
PAGE_2: LED513.A, U502.12 (QC), U505.4 (A3)
PAGE_3: LED512.A, U502.11 (QD), U505.5 (A4)
PAGE_4: LED511.A, U503.14 (QA), U505.6 (A5)
PAGE_5: LED510.A, U503.13 (QB), U505.7 (A6)
PAGE_6: LED509.A, U503.12 (QC), U505.8 (A7)
PAGE_7: LED508.A, U503.11 (QD), U505.9 (A8)
VCC: C500.1, C501.1, C502.1, C503.1, C504.1, C505.1, U500.10 (ENT), U500.16 (VCC), U501.16 (VCC), U502.16 (VCC), U503.16 (VCC), U504.1 (DIR), U504.20 (VCC), U505.1 (DIR), U505.20 (VCC); also elsewhere on the board
