BlockWorker/EE-8BitComputer/main.brd

## EAGLE design main.brd (continued)

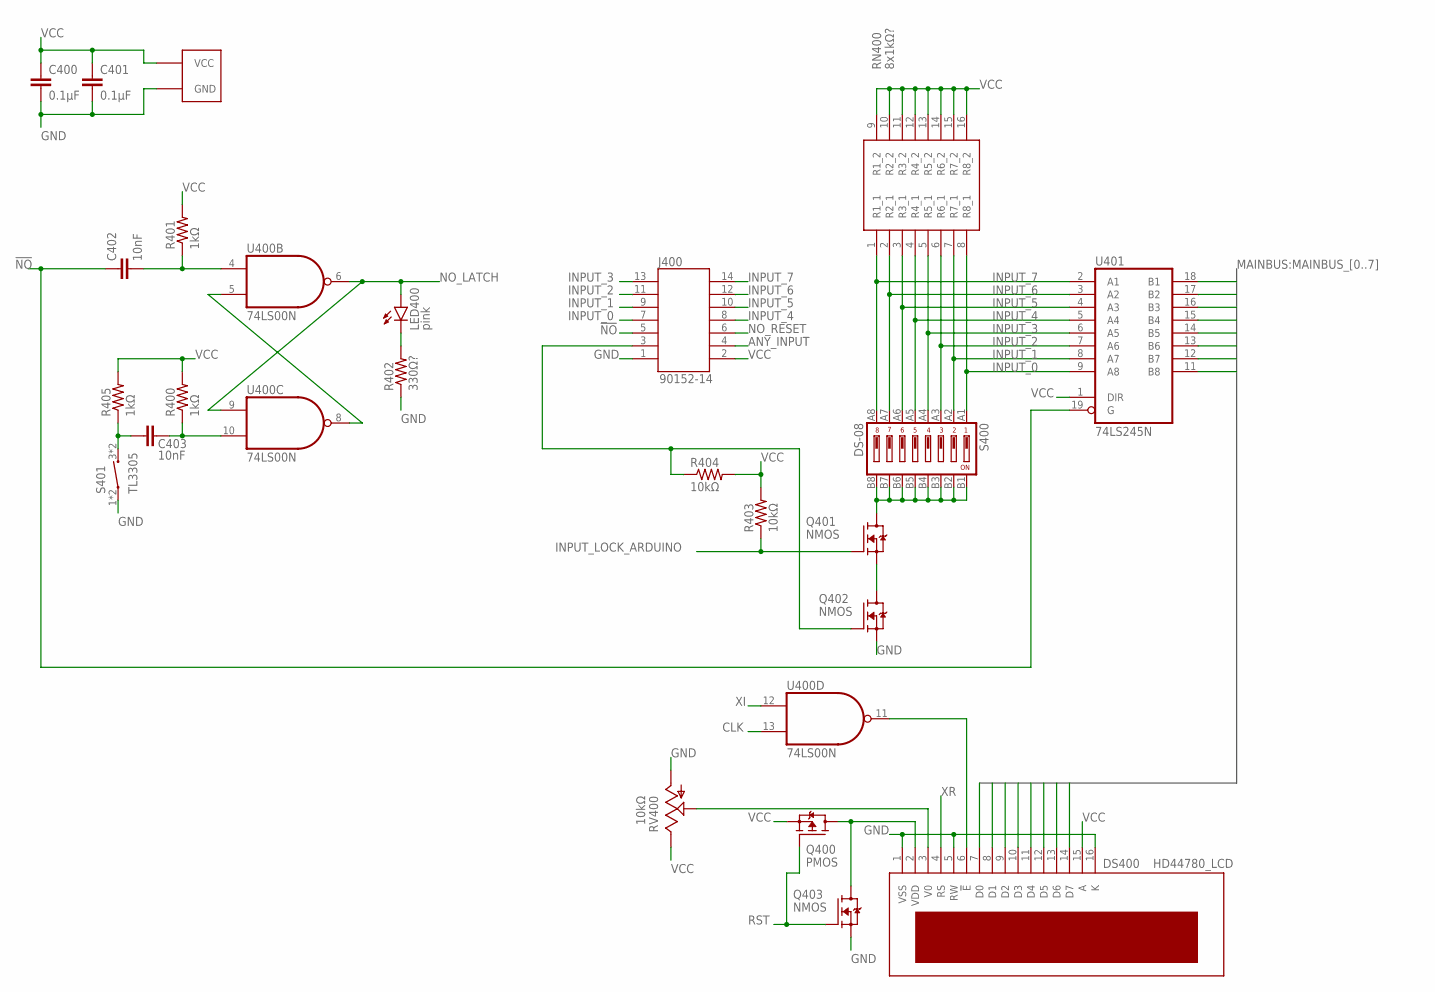
[picture p6: schematic main.sch, sheet 5, User Input & LCD]

Parts:
C400, C401: 0.1µF; C0805K
C402, C403: 10nF; C0805K
DS400: HD44780_LCD
J400: 90152-14
LED400: pink; LED3MM
Q400: PMOS; SOT23
Q401, Q402, Q403: NMOS; SOT23
R400, R401, R405: 1kΩ; R0805
R402: 330Ω?; R0805
R403, R404: 10kΩ; R0805
RN400: 8x1kΩ?; CAY16102J8LF
RV400: 10kΩ; CA9V
S400: DS-08; DIPSW-08
S401: TL3305; TL3305_MICROSWITCH
U400: 74LS00N; DIL14
U401: 74LS245N; DIL20

Connections:
!LCD_E: DS400.6 (!E), U400.11 (O)
!NO: C402.1, J400.5, U401.19 (G); also elsewhere on the board
!NO_LATCH: U400.5 (I1), U400.8 (O)
ANY_INPUT: J400.4; also elsewhere on the board
CLK: U400.13 (I1); also elsewhere on the board
GND: C400.2, C401.2, DS400.1 (VSS), DS400.5 (RW), DS400.16 (K), J400.1, Q402.2 (S), Q403.2 (S), R402.1, RV400.A, S401.1, S401.2 (1), U400.7 (GND), U401.10 (GND); also elsewhere on the board
INPUT_0: J400.7, RN400.8 (R8_1), S400.A1 (1), U401.9 (A8); also elsewhere on the board
INPUT_1: J400.9, RN400.7 (R7_1), S400.A2 (2), U401.8 (A7); also elsewhere on the board
INPUT_2: J400.11, RN400.6 (R6_1), S400.A3 (3), U401.7 (A6); also elsewhere on the board
INPUT_3: J400.13, RN400.5 (R5_1), S400.A4 (4), U401.6 (A5); also elsewhere on the board
INPUT_4: J400.8, RN400.4 (R4_1), S400.A5 (5), U401.5 (A4); also elsewhere on the board
INPUT_5: J400.10, RN400.3 (R3_1), S400.A6 (6), U401.4 (A3); also elsewhere on the board
INPUT_6: J400.12, RN400.2 (R2_1), S400.A7 (7), U401.3 (A2); also elsewhere on the board
INPUT_7: J400.14, RN400.1 (R1_1), S400.A8 (8), U401.2 (A1); also elsewhere on the board
INPUT_GND: Q401.3 (D), S400.B1 (16), S400.B2 (15), S400.B3 (14), S400.B4 (13), S400.B5 (12), S400.B6 (11), S400.B7 (10), S400.B8 (9)
INPUT_GND_INT: Q401.2 (S), Q402.3 (D)
INPUT_LOCK_ARDUINO: Q401.1 (G), R403.1; also elsewhere on the board
INPUT_LOCK_EXT: J400.3, Q402.1 (G), R404.1
LCD_V0: DS400.3 (V0), RV400.S
LCD_VDD: DS400.2 (VDD), Q400.3 (D), Q403.3 (D)
MAINBUS_0: DS400.7 (D0), U401.11 (B8); also elsewhere on the board
MAINBUS_1: DS400.8 (D1), U401.12 (B7); also elsewhere on the board
MAINBUS_2: DS400.9 (D2), U401.13 (B6); also elsewhere on the board
MAINBUS_3: DS400.10 (D3), U401.14 (B5); also elsewhere on the board
MAINBUS_4: DS400.11 (D4), U401.15 (B4); also elsewhere on the board
MAINBUS_5: DS400.12 (D5), U401.16 (B3); also elsewhere on the board
MAINBUS_6: DS400.13 (D6), U401.17 (B2); also elsewhere on the board
MAINBUS_7: DS400.14 (D7), U401.18 (B1); also elsewhere on the board
NO_LATCH: LED400.A, U400.6 (O), U400.9 (I0); also elsewhere on the board
NO_LED: LED400.K (C), R402.2
NO_RESET: C403.1, J400.6, R405.1, S401.3 (2), S401.4 (2); also elsewhere on the board
NO_RESET_PULSE: C403.2, R400.1, U400.10 (I1)
NO_SET_PULSE: C402.2, R401.1, U400.4 (I0)
RST: Q400.1 (G), Q403.1 (G); also elsewhere on the board
VCC: C400.1, C401.1, DS400.15 (A), J400.2, Q400.2 (S), R400.2, R401.2, R403.2, R404.2, R405.2, RN400.9 (R1_2), RN400.10 (R2_2), RN400.11 (R3_2), RN400.12 (R4_2), RN400.13 (R5_2), RN400.14 (R6_2), RN400.15 (R7_2), RN400.16 (R8_2), RV400.E, U400.14 (VCC), U401.1 (DIR), U401.20 (VCC); also elsewhere on the board
XI: U400.12 (I0); also elsewhere on the board
XR: DS400.4 (RS); also elsewhere on the board

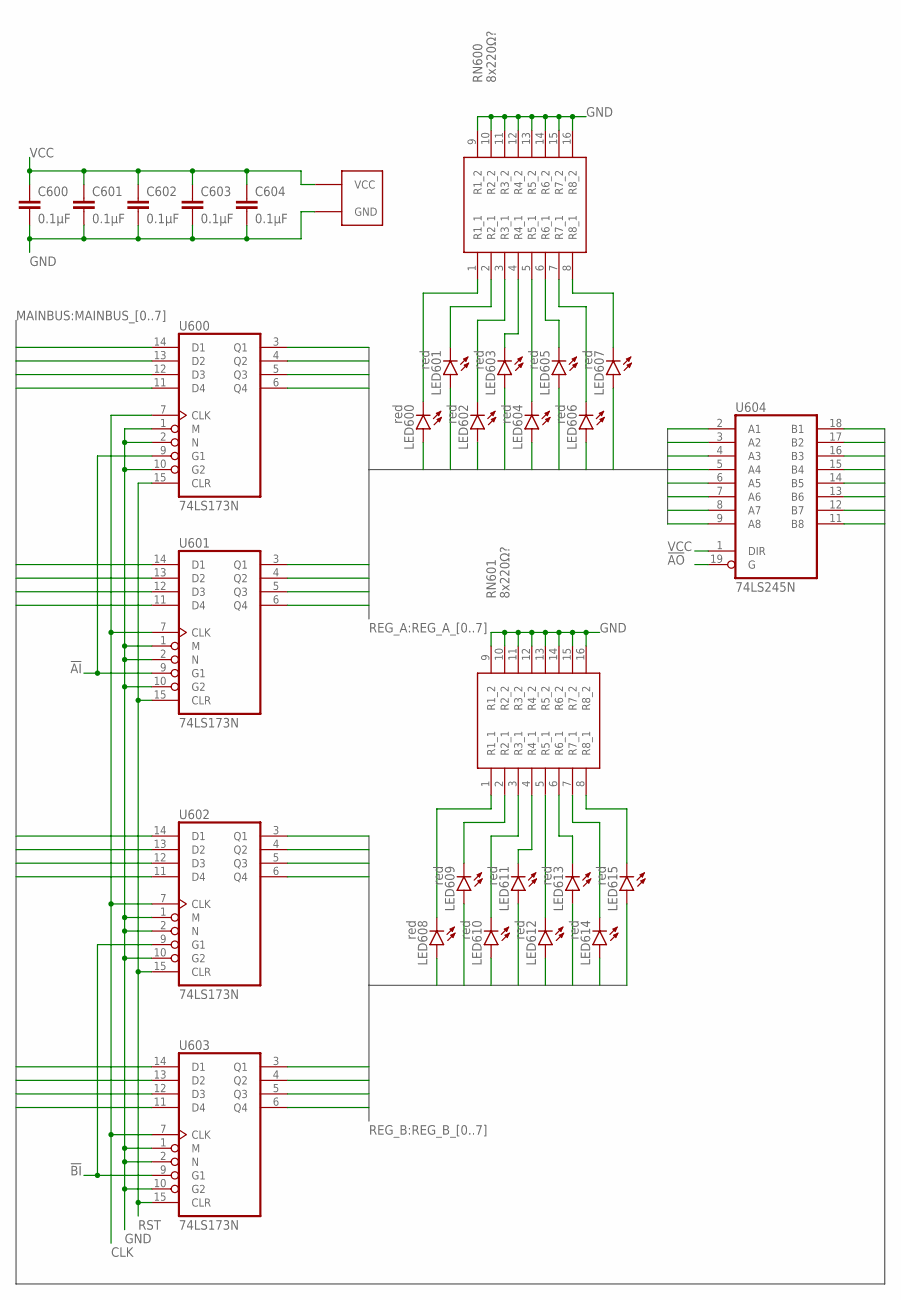
[picture p7: schematic main.sch, sheet 6, A & B Registers]

Parts:
C600, C601, C602, C603, C604: 0.1µF; C0805K
LED600, LED601, LED602, LED603, LED604, LED605, LED606, LED607, LED608, LED609, LED610, LED611, LED612, LED613, LED614, LED615: red; LED3MM
RN600, RN601: 8x220Ω?; CAY16102J8LF
U600, U601, U602, U603: 74LS173N; DIL16
U604: 74LS245N; DIL20

Connections:
!AI: U600.9 (G1), U601.9 (G1); also elsewhere on the board
!AO: U604.19 (G); also elsewhere on the board
!BI: U602.9 (G1), U603.9 (G1); also elsewhere on the board
CLK: U600.7 (CLK), U601.7 (CLK), U602.7 (CLK), U603.7 (CLK); also elsewhere on the board
GND: C600.2, C601.2, C602.2, C603.2, C604.2, RN600.9 (R1_2), RN600.10 (R2_2), RN600.11 (R3_2), RN600.12 (R4_2), RN600.13 (R5_2), RN600.14 (R6_2), RN600.15 (R7_2), RN600.16 (R8_2), RN601.9 (R1_2), RN601.10 (R2_2), RN601.11 (R3_2), RN601.12 (R4_2), RN601.13 (R5_2), RN601.14 (R6_2), RN601.15 (R7_2), RN601.16 (R8_2), U600.1 (M), U600.2 (N), U600.8 (GND), U600.10 (G2), U601.1 (M), U601.2 (N), U601.8 (GND), U601.10 (G2), U602.1 (M), U602.2 (N), U602.8 (GND), U602.10 (G2), U603.1 (M), U603.2 (N), U603.8 (GND), U603.10 (G2), U604.10 (GND); also elsewhere on the board
LED600_GND: LED600.K (C), RN600.1 (R1_1)
LED601_GND: LED601.K (C), RN600.2 (R2_1)
LED602_GND: LED602.K (C), RN600.3 (R3_1)
LED603_GND: LED603.K (C), RN600.4 (R4_1)
LED604_GND: LED604.K (C), RN600.5 (R5_1)
LED605_GND: LED605.K (C), RN600.6 (R6_1)
LED606_GND: LED606.K (C), RN600.7 (R7_1)
LED607_GND: LED607.K (C), RN600.8 (R8_1)
LED608_GND: LED608.K (C), RN601.1 (R1_1)
LED609_GND: LED609.K (C), RN601.2 (R2_1)
LED610_GND: LED610.K (C), RN601.3 (R3_1)
LED611_GND: LED611.K (C), RN601.4 (R4_1)
LED612_GND: LED612.K (C), RN601.5 (R5_1)
LED613_GND: LED613.K (C), RN601.6 (R6_1)
LED614_GND: LED614.K (C), RN601.7 (R7_1)
LED615_GND: LED615.K (C), RN601.8 (R8_1)
MAINBUS_0: U601.11 (D4), U603.11 (D4), U604.11 (B8); also elsewhere on the board
MAINBUS_1: U601.12 (D3), U603.12 (D3), U604.12 (B7); also elsewhere on the board
MAINBUS_2: U601.13 (D2), U603.13 (D2), U604.13 (B6); also elsewhere on the board
MAINBUS_3: U601.14 (D1), U603.14 (D1), U604.14 (B5); also elsewhere on the board
MAINBUS_4: U600.11 (D4), U602.11 (D4), U604.15 (B4); also elsewhere on the board
MAINBUS_5: U600.12 (D3), U602.12 (D3), U604.16 (B3); also elsewhere on the board
MAINBUS_6: U600.13 (D2), U602.13 (D2), U604.17 (B2); also elsewhere on the board
MAINBUS_7: U600.14 (D1), U602.14 (D1), U604.18 (B1); also elsewhere on the board
REG_A_0: LED607.A, U601.6 (Q4), U604.9 (A8); also elsewhere on the board
REG_A_1: LED606.A, U601.5 (Q3), U604.8 (A7); also elsewhere on the board
REG_A_2: LED605.A, U601.4 (Q2), U604.7 (A6); also elsewhere on the board
REG_A_3: LED604.A, U601.3 (Q1), U604.6 (A5); also elsewhere on the board
REG_A_4: LED603.A, U600.6 (Q4), U604.5 (A4); also elsewhere on the board
REG_A_5: LED602.A, U600.5 (Q3), U604.4 (A3); also elsewhere on the board
REG_A_6: LED601.A, U600.4 (Q2), U604.3 (A2); also elsewhere on the board
REG_A_7: LED600.A, U600.3 (Q1), U604.2 (A1); also elsewhere on the board
REG_B_0: LED615.A, U603.6 (Q4); also elsewhere on the board
REG_B_1: LED614.A, U603.5 (Q3); also elsewhere on the board
REG_B_2: LED613.A, U603.4 (Q2); also elsewhere on the board
REG_B_3: LED612.A, U603.3 (Q1); also elsewhere on the board
REG_B_4: LED611.A, U602.6 (Q4); also elsewhere on the board
REG_B_5: LED610.A, U602.5 (Q3); also elsewhere on the board
REG_B_6: LED609.A, U602.4 (Q2); also elsewhere on the board
REG_B_7: LED608.A, U602.3 (Q1); also elsewhere on the board
RST: U600.15 (CLR), U601.15 (CLR), U602.15 (CLR), U603.15 (CLR); also elsewhere on the board
VCC: C600.1, C601.1, C602.1, C603.1, C604.1, U600.16 (VCC), U601.16 (VCC), U602.16 (VCC), U603.16 (VCC), U604.1 (DIR), U604.20 (VCC); also elsewhere on the board

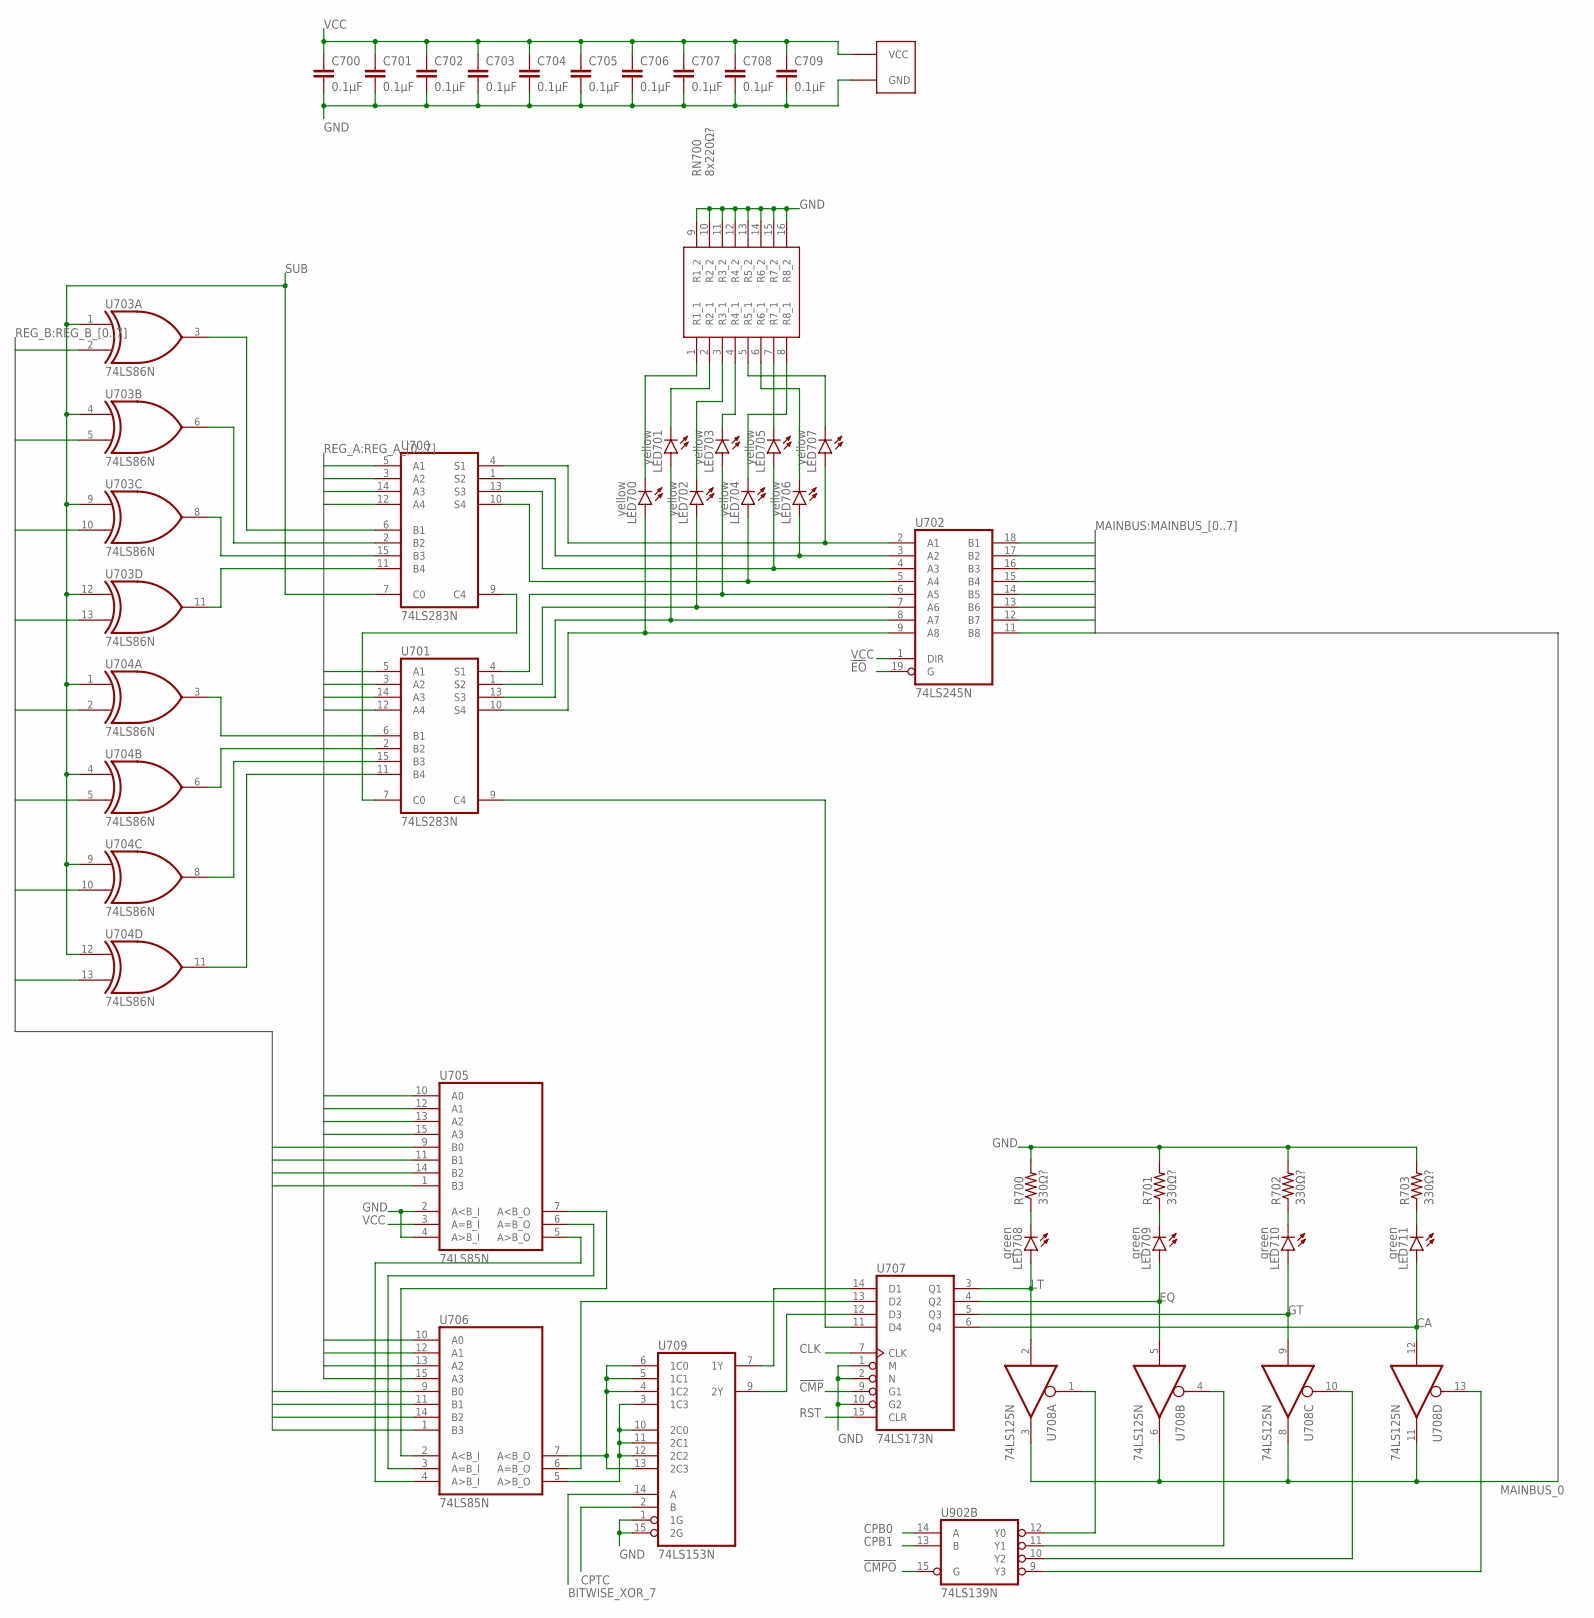
[picture p8: schematic main.sch, sheet 7, ALU & Comparator]

Parts:
C700, C701, C702, C703, C704, C705, C706, C707, C708, C709: 0.1µF; C0805K
LED700, LED701, LED702, LED703, LED704, LED705, LED706, LED707: yellow; LED3MM
LED708, LED709, LED710, LED711: green; LED3MM
R700, R701, R702, R703: 330Ω?; R0805
RN700: 8x220Ω?; CAY16102J8LF
U700, U701: 74LS283N; DIL16
U702: 74LS245N; DIL20
U703, U704: 74LS86N; DIL14
U705, U706: 74LS85N; DIL16
U707: 74LS173N; DIL16
U708: 74LS125N; DIL14
U709: 74LS153N; DIL16
U902: 74LS139N; DIL16

Connections:
!CMP: U707.9 (G1); also elsewhere on the board
!CMPO: U902.15 (G); also elsewhere on the board
!CMP_CA_OUT: U708.13 (OE), U902.9 (Y3)
!CMP_EQ_OUT: U708.4 (OE), U902.11 (Y1)
!CMP_GT_OUT: U708.10 (OE), U902.10 (Y2)
!CMP_LT_OUT: U708.1 (OE), U902.12 (Y0)
!EO: U702.19 (G); also elsewhere on the board
ALU_B_0: U700.6 (B1), U703.3 (O)
ALU_B_1: U700.2 (B2), U703.6 (O)
ALU_B_2: U700.15 (B3), U703.8 (O)
ALU_B_3: U700.11 (B4), U703.11 (O)
ALU_B_4: U701.6 (B1), U704.3 (O)
ALU_B_5: U701.2 (B2), U704.6 (O)
ALU_B_6: U701.15 (B3), U704.8 (O)
ALU_B_7: U701.11 (B4), U704.11 (O)
ALU_CARRY_OVER: U701.9 (C4), U707.11 (D4)
ALU_INT_CARRY: U700.9 (C4), U701.7 (C0)
ALU_SUM_0: LED707.A, U700.4 (S1), U702.2 (A1)
ALU_SUM_1: LED706.A, U700.1 (S2), U702.3 (A2)
ALU_SUM_2: LED705.A, U700.13 (S3), U702.4 (A3)
ALU_SUM_3: LED704.A, U700.10 (S4), U702.5 (A4)
ALU_SUM_4: LED703.A, U701.4 (S1), U702.6 (A5)
ALU_SUM_5: LED702.A, U701.1 (S2), U702.7 (A6)
ALU_SUM_6: LED701.A, U701.13 (S3), U702.8 (A7)
ALU_SUM_7: LED700.A, U701.10 (S4), U702.9 (A8)
BITWISE_XOR_7: U709.14 (A); also elsewhere on the board
CA: LED711.A, U707.6 (Q4), U708.12 (I)
CLK: U707.7 (CLK); also elsewhere on the board
CMP_<_CARRY: U705.7 (A<B_O), U706.2 (A<B_I)
CMP_=_CARRY: U705.6 (A=B_O), U706.3 (A=B_I)
CMP_>_CARRY: U705.5 (A>B_O), U706.4 (A>B_I)
CMP_EQ_INT: U706.6 (A=B_O), U707.13 (D2)
CMP_GT_INT: U707.12 (D3), U709.9 (2Y)
CMP_GT_PRE: U706.5 (A>B_O), U709.3 (1C3), U709.10 (2C0), U709.11 (2C1), U709.12 (2C2)
CMP_LT_INT: U707.14 (D1), U709.7 (1Y)
CMP_LT_PRE: U706.7 (A<B_O), U709.4 (1C2), U709.5 (1C1), U709.6 (1C0), U709.13 (2C3)
CPB0: U902.14 (A); also elsewhere on the board
CPB1: U902.13 (B); also elsewhere on the board
CPTC: U709.2 (B); also elsewhere on the board
EQ: LED709.A, U707.4 (Q2), U708.5 (I)
GND: C700.2, C701.2, C702.2, C703.2, C704.2, C705.2, C706.2, C707.2, C708.2, C709.2, R700.2, R701.2, R702.2, R703.2, RN700.9 (R1_2), RN700.10 (R2_2), RN700.11 (R3_2), RN700.12 (R4_2), RN700.13 (R5_2), RN700.14 (R6_2), RN700.15 (R7_2), RN700.16 (R8_2), U700.8 (GND), U701.8 (GND), U702.10 (GND), U703.7 (GND), U704.7 (GND), U705.2 (A<B_I), U705.4 (A>B_I), U705.8 (GND), U706.8 (GND), U707.1 (M), U707.2 (N), U707.8 (GND), U707.10 (G2), U708.7 (GND), U709.1 (1G), U709.8 (GND), U709.15 (2G), U902.8 (GND); also elsewhere on the board
GT: LED710.A, U707.5 (Q3), U708.9 (I); also elsewhere on the board
LED700_GND: LED700.K (C), RN700.1 (R1_1)
LED701_GND: LED701.K (C), RN700.2 (R2_1)
LED702_GND: LED702.K (C), RN700.3 (R3_1)
LED703_GND: LED703.K (C), RN700.4 (R4_1)
LED704_GND: LED704.K (C), RN700.8 (R8_1)
LED705_GND: LED705.K (C), RN700.7 (R7_1)
LED706_GND: LED706.K (C), RN700.6 (R6_1)
LED707_GND: LED707.K (C), RN700.5 (R5_1)
LED708_GND: LED708.K (C), R700.1
LED709_GND: LED709.K (C), R701.1
LED710_GND: LED710.K (C), R702.1
LED711_GND: LED711.K (C), R703.1
LT: LED708.A, U707.3 (Q1), U708.2 (I); also elsewhere on the board
MAINBUS_0: U702.18 (B1), U708.3 (O), U708.6 (O), U708.8 (O), U708.11 (O); also elsewhere on the board
MAINBUS_1: U702.17 (B2); also elsewhere on the board
MAINBUS_2: U702.16 (B3); also elsewhere on the board
MAINBUS_3: U702.15 (B4); also elsewhere on the board
MAINBUS_4: U702.14 (B5); also elsewhere on the board
MAINBUS_5: U702.13 (B6); also elsewhere on the board
MAINBUS_6: U702.12 (B7); also elsewhere on the board
MAINBUS_7: U702.11 (B8); also elsewhere on the board
REG_A_0: U700.5 (A1), U705.10 (A0); also elsewhere on the board
REG_A_1: U700.3 (A2), U705.12 (A1); also elsewhere on the board
REG_A_2: U700.14 (A3), U705.13 (A2); also elsewhere on the board
REG_A_3: U700.12 (A4), U705.15 (A3); also elsewhere on the board
REG_A_4: U701.5 (A1), U706.10 (A0); also elsewhere on the board
REG_A_5: U701.3 (A2), U706.12 (A1); also elsewhere on the board
REG_A_6: U701.14 (A3), U706.13 (A2); also elsewhere on the board
REG_A_7: U701.12 (A4), U706.15 (A3); also elsewhere on the board
REG_B_0: U703.2 (I1), U705.9 (B0); also elsewhere on the board
REG_B_1: U703.5 (I1), U705.11 (B1); also elsewhere on the board
REG_B_2: U703.10 (I1), U705.14 (B2); also elsewhere on the board
REG_B_3: U703.13 (I1), U705.1 (B3); also elsewhere on the board
REG_B_4: U704.2 (I1), U706.9 (B0); also elsewhere on the board
REG_B_5: U704.5 (I1), U706.11 (B1); also elsewhere on the board
REG_B_6: U704.10 (I1), U706.14 (B2); also elsewhere on the board
REG_B_7: U704.13 (I1), U706.1 (B3); also elsewhere on the board
RST: U707.15 (CLR); also elsewhere on the board
SUB: U700.7 (C0), U703.1 (I0), U703.4 (I0), U703.9 (I0), U703.12 (I0), U704.1 (I0), U704.4 (I0), U704.9 (I0), U704.12 (I0); also elsewhere on the board
VCC: C700.1, C701.1, C702.1, C703.1, C704.1, C705.1, C706.1, C707.1, C708.1, C709.1, U700.16 (VCC), U701.16 (VCC), U702.1 (DIR), U702.20 (VCC), U703.14 (VCC), U704.14 (VCC), U705.3 (A=B_I), U705.16 (VCC), U706.16 (VCC), U707.16 (VCC), U708.14 (VCC), U709.16 (VCC), U902.16 (VCC); also elsewhere on the board

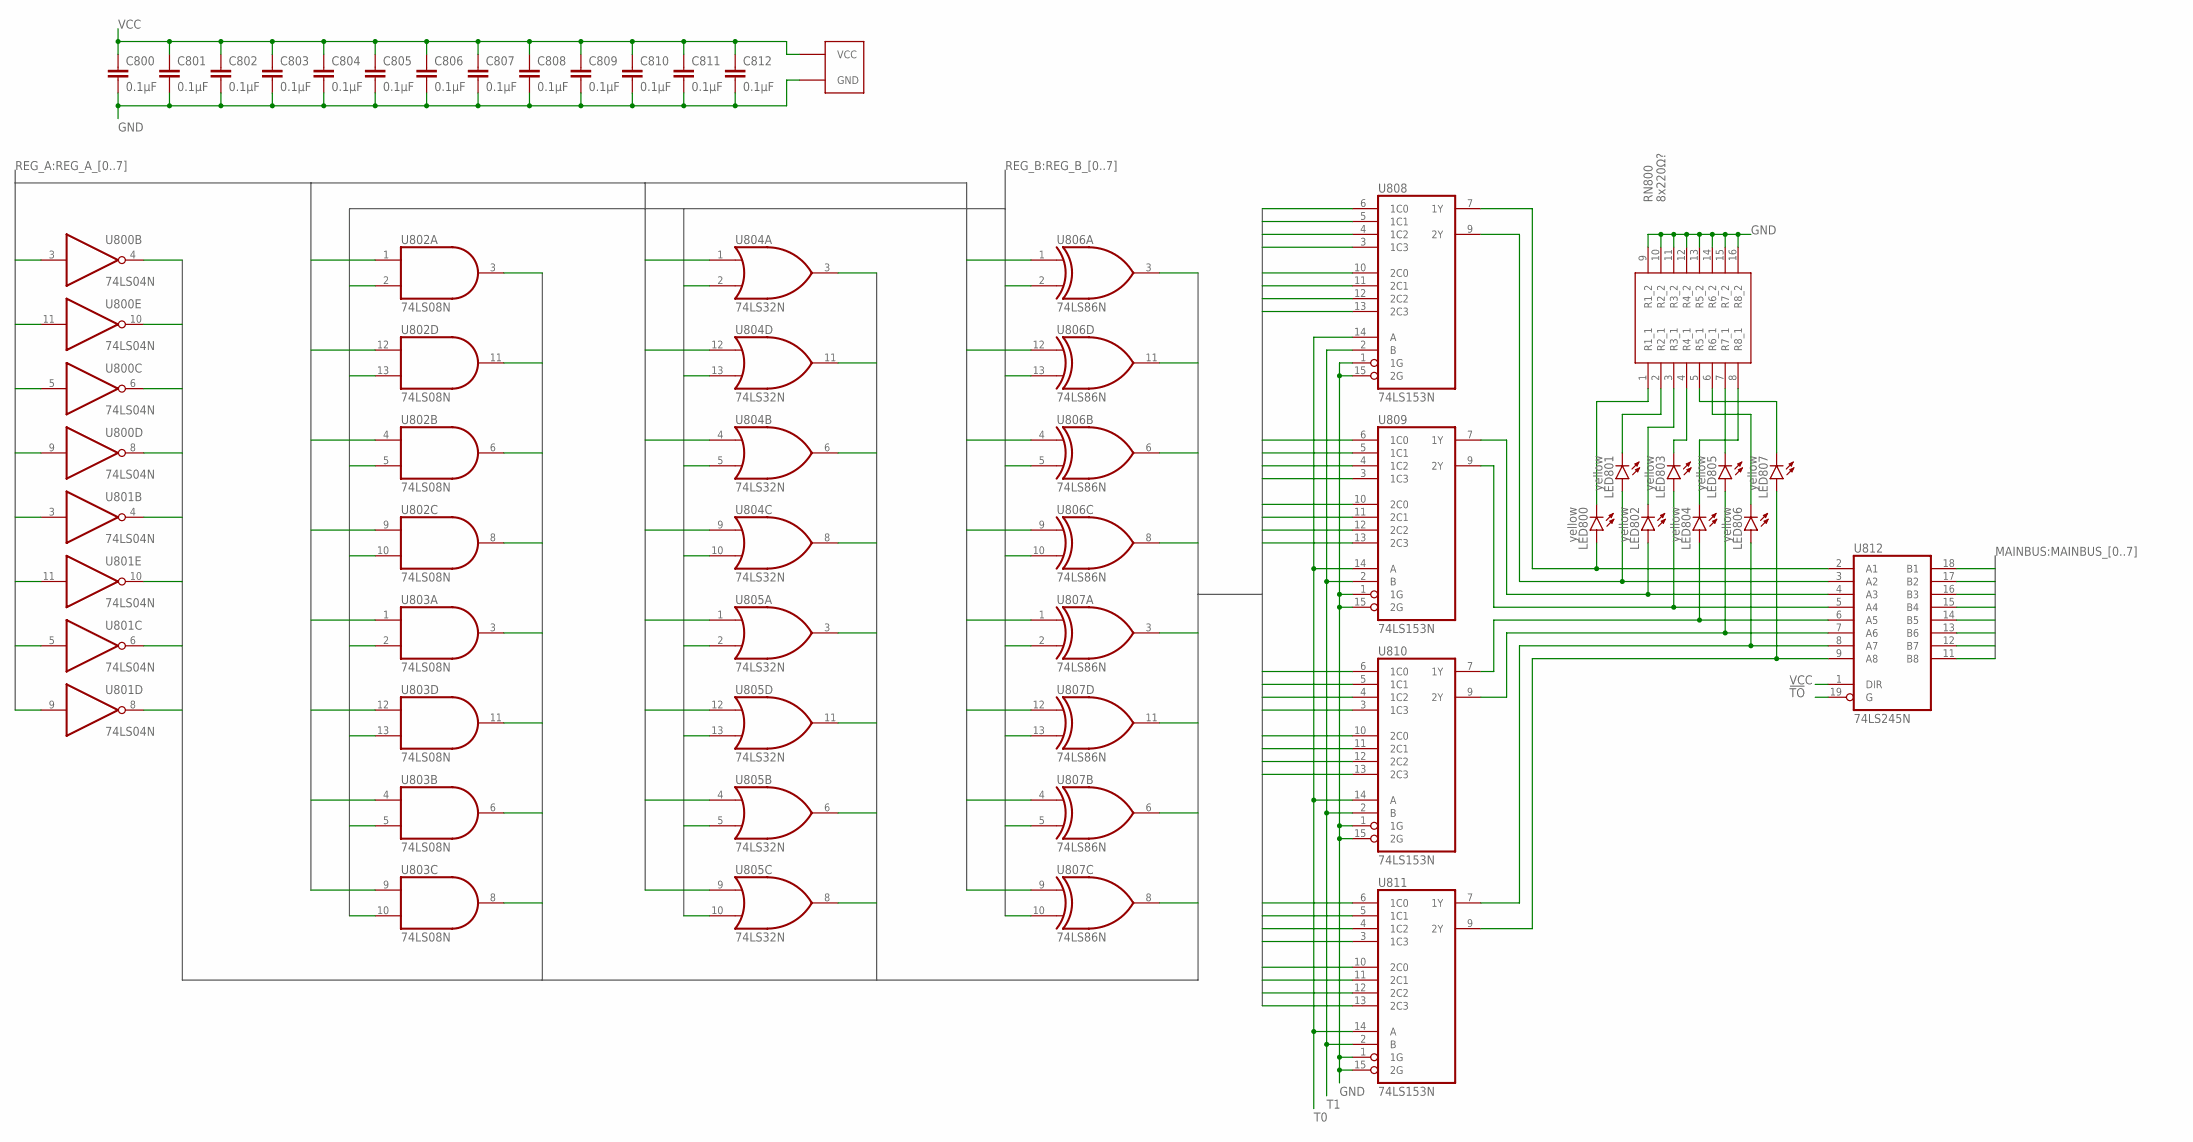
[picture p9: schematic main.sch, sheet 8, Bitwise Operations]

Parts:
C800, C801, C802, C803, C804, C805, C806, C807, C808, C809, C810, C811, C812: 0.1µF; C0805K
LED800, LED801, LED802, LED803, LED804, LED805, LED806, LED807: yellow; LED3MM
RN800: 8x220Ω?; CAY16102J8LF
U800, U801: 74LS04N; DIL14
U802, U803: 74LS08N; DIL14
U804, U805: 74LS32N; DIL14
U806, U807: 74LS86N; DIL14
U808, U809, U810, U811: 74LS153N; DIL16
U812: 74LS245N; DIL20

Connections:
!TO: U812.19 (G); also elsewhere on the board
BITWISE_AND_0: U803.8 (O), U811.11 (2C1)
BITWISE_AND_1: U803.6 (O), U811.5 (1C1)
BITWISE_AND_2: U803.11 (O), U810.11 (2C1)
BITWISE_AND_3: U803.3 (O), U810.5 (1C1)
BITWISE_AND_4: U802.8 (O), U809.11 (2C1)
BITWISE_AND_5: U802.6 (O), U809.5 (1C1)
BITWISE_AND_6: U802.11 (O), U808.11 (2C1)
BITWISE_AND_7: U802.3 (O), U808.5 (1C1)
BITWISE_NOT_0: U801.8 (O), U811.10 (2C0)
BITWISE_NOT_1: U801.6 (O), U811.6 (1C0)
BITWISE_NOT_2: U801.10 (O), U810.10 (2C0)
BITWISE_NOT_3: U801.4 (O), U810.6 (1C0)
BITWISE_NOT_4: U800.8 (O), U809.10 (2C0)
BITWISE_NOT_5: U800.6 (O), U809.6 (1C0)
BITWISE_NOT_6: U800.10 (O), U808.10 (2C0)
BITWISE_NOT_7: U800.4 (O), U808.6 (1C0)
BITWISE_OR_0: U805.8 (O), U811.12 (2C2)
BITWISE_OR_1: U805.6 (O), U811.4 (1C2)
BITWISE_OR_2: U805.11 (O), U810.12 (2C2)
BITWISE_OR_3: U805.3 (O), U810.4 (1C2)
BITWISE_OR_4: U804.8 (O), U809.12 (2C2)
BITWISE_OR_5: U804.6 (O), U809.4 (1C2)
BITWISE_OR_6: U804.11 (O), U808.12 (2C2)
BITWISE_OR_7: U804.3 (O), U808.4 (1C2)
BITWISE_OUT_0: LED807.A, U811.9 (2Y), U812.9 (A8)
BITWISE_OUT_1: LED806.A, U811.7 (1Y), U812.8 (A7)
BITWISE_OUT_2: LED805.A, U810.9 (2Y), U812.7 (A6)
BITWISE_OUT_3: LED804.A, U810.7 (1Y), U812.6 (A5)
BITWISE_OUT_4: LED803.A, U809.9 (2Y), U812.5 (A4)
BITWISE_OUT_5: LED802.A, U809.7 (1Y), U812.4 (A3)
BITWISE_OUT_6: LED801.A, U808.9 (2Y), U812.3 (A2)
BITWISE_OUT_7: LED800.A, U808.7 (1Y), U812.2 (A1)
BITWISE_XOR_0: U807.8 (O), U811.13 (2C3)
BITWISE_XOR_1: U807.6 (O), U811.3 (1C3)
BITWISE_XOR_2: U807.11 (O), U810.13 (2C3)
BITWISE_XOR_3: U807.3 (O), U810.3 (1C3)
BITWISE_XOR_4: U806.8 (O), U809.13 (2C3)
BITWISE_XOR_5: U806.6 (O), U809.3 (1C3)
BITWISE_XOR_6: U806.11 (O), U808.13 (2C3)
BITWISE_XOR_7: U806.3 (O), U808.3 (1C3); also elsewhere on the board
GND: C800.2, C801.2, C802.2, C803.2, C804.2, C805.2, C806.2, C807.2, C808.2, C809.2, C810.2, C811.2, C812.2, RN800.9 (R1_2), RN800.10 (R2_2), RN800.11 (R3_2), RN800.12 (R4_2), RN800.13 (R5_2), RN800.14 (R6_2), RN800.15 (R7_2), RN800.16 (R8_2), U800.7 (GND), U801.7 (GND), U802.7 (GND), U803.7 (GND), U804.7 (GND), U805.7 (GND), U806.7 (GND), U807.7 (GND), U808.1 (1G), U808.8 (GND), U808.15 (2G), U809.1 (1G), U809.8 (GND), U809.15 (2G), U810.1 (1G), U810.8 (GND), U810.15 (2G), U811.1 (1G), U811.8 (GND), U811.15 (2G), U812.10 (GND); also elsewhere on the board
LED800_GND: LED800.K (C), RN800.1 (R1_1)
LED801_GND: LED801.K (C), RN800.2 (R2_1)
LED802_GND: LED802.K (C), RN800.3 (R3_1)
LED803_GND: LED803.K (C), RN800.4 (R4_1)
LED804_GND: LED804.K (C), RN800.8 (R8_1)
LED805_GND: LED805.K (C), RN800.7 (R7_1)
LED806_GND: LED806.K (C), RN800.6 (R6_1)
LED807_GND: LED807.K (C), RN800.5 (R5_1)
MAINBUS_0: U812.11 (B8); also elsewhere on the board
MAINBUS_1: U812.12 (B7); also elsewhere on the board
MAINBUS_2: U812.13 (B6); also elsewhere on the board
MAINBUS_3: U812.14 (B5); also elsewhere on the board
MAINBUS_4: U812.15 (B4); also elsewhere on the board
MAINBUS_5: U812.16 (B3); also elsewhere on the board
MAINBUS_6: U812.17 (B2); also elsewhere on the board
MAINBUS_7: U812.18 (B1); also elsewhere on the board
REG_A_0: U801.9 (I), U803.9 (I0), U805.9 (I0), U807.9 (I0); also elsewhere on the board
REG_A_1: U801.5 (I), U803.4 (I0), U805.4 (I0), U807.4 (I0); also elsewhere on the board
REG_A_2: U801.11 (I), U803.12 (I0), U805.12 (I0), U807.12 (I0); also elsewhere on the board
REG_A_3: U801.3 (I), U803.1 (I0), U805.1 (I0), U807.1 (I0); also elsewhere on the board
REG_A_4: U800.9 (I), U802.9 (I0), U804.9 (I0), U806.9 (I0); also elsewhere on the board
REG_A_5: U800.5 (I), U802.4 (I0), U804.4 (I0), U806.4 (I0); also elsewhere on the board
REG_A_6: U800.11 (I), U802.12 (I0), U804.12 (I0), U806.12 (I0); also elsewhere on the board
REG_A_7: U800.3 (I), U802.1 (I0), U804.1 (I0), U806.1 (I0); also elsewhere on the board
REG_B_0: U803.10 (I1), U805.10 (I1), U807.10 (I1); also elsewhere on the board
REG_B_1: U803.5 (I1), U805.5 (I1), U807.5 (I1); also elsewhere on the board
REG_B_2: U803.13 (I1), U805.13 (I1), U807.13 (I1); also elsewhere on the board
REG_B_3: U803.2 (I1), U805.2 (I1), U807.2 (I1); also elsewhere on the board
REG_B_4: U802.10 (I1), U804.10 (I1), U806.10 (I1); also elsewhere on the board
REG_B_5: U802.5 (I1), U804.5 (I1), U806.5 (I1); also elsewhere on the board
REG_B_6: U802.13 (I1), U804.13 (I1), U806.13 (I1); also elsewhere on the board
REG_B_7: U802.2 (I1), U804.2 (I1), U806.2 (I1); also elsewhere on the board
T0: U808.14 (A), U809.14 (A), U810.14 (A), U811.14 (A); also elsewhere on the board
T1: U808.2 (B), U809.2 (B), U810.2 (B), U811.2 (B); also elsewhere on the board
VCC: C800.1, C801.1, C802.1, C803.1, C804.1, C805.1, C806.1, C807.1, C808.1, C809.1, C810.1, C811.1, C812.1, U800.14 (VCC), U801.14 (VCC), U802.14 (VCC), U803.14 (VCC), U804.14 (VCC), U805.14 (VCC), U806.14 (VCC), U807.14 (VCC), U808.16 (VCC), U809.16 (VCC), U810.16 (VCC), U811.16 (VCC), U812.1 (DIR), U812.20 (VCC); also elsewhere on the board

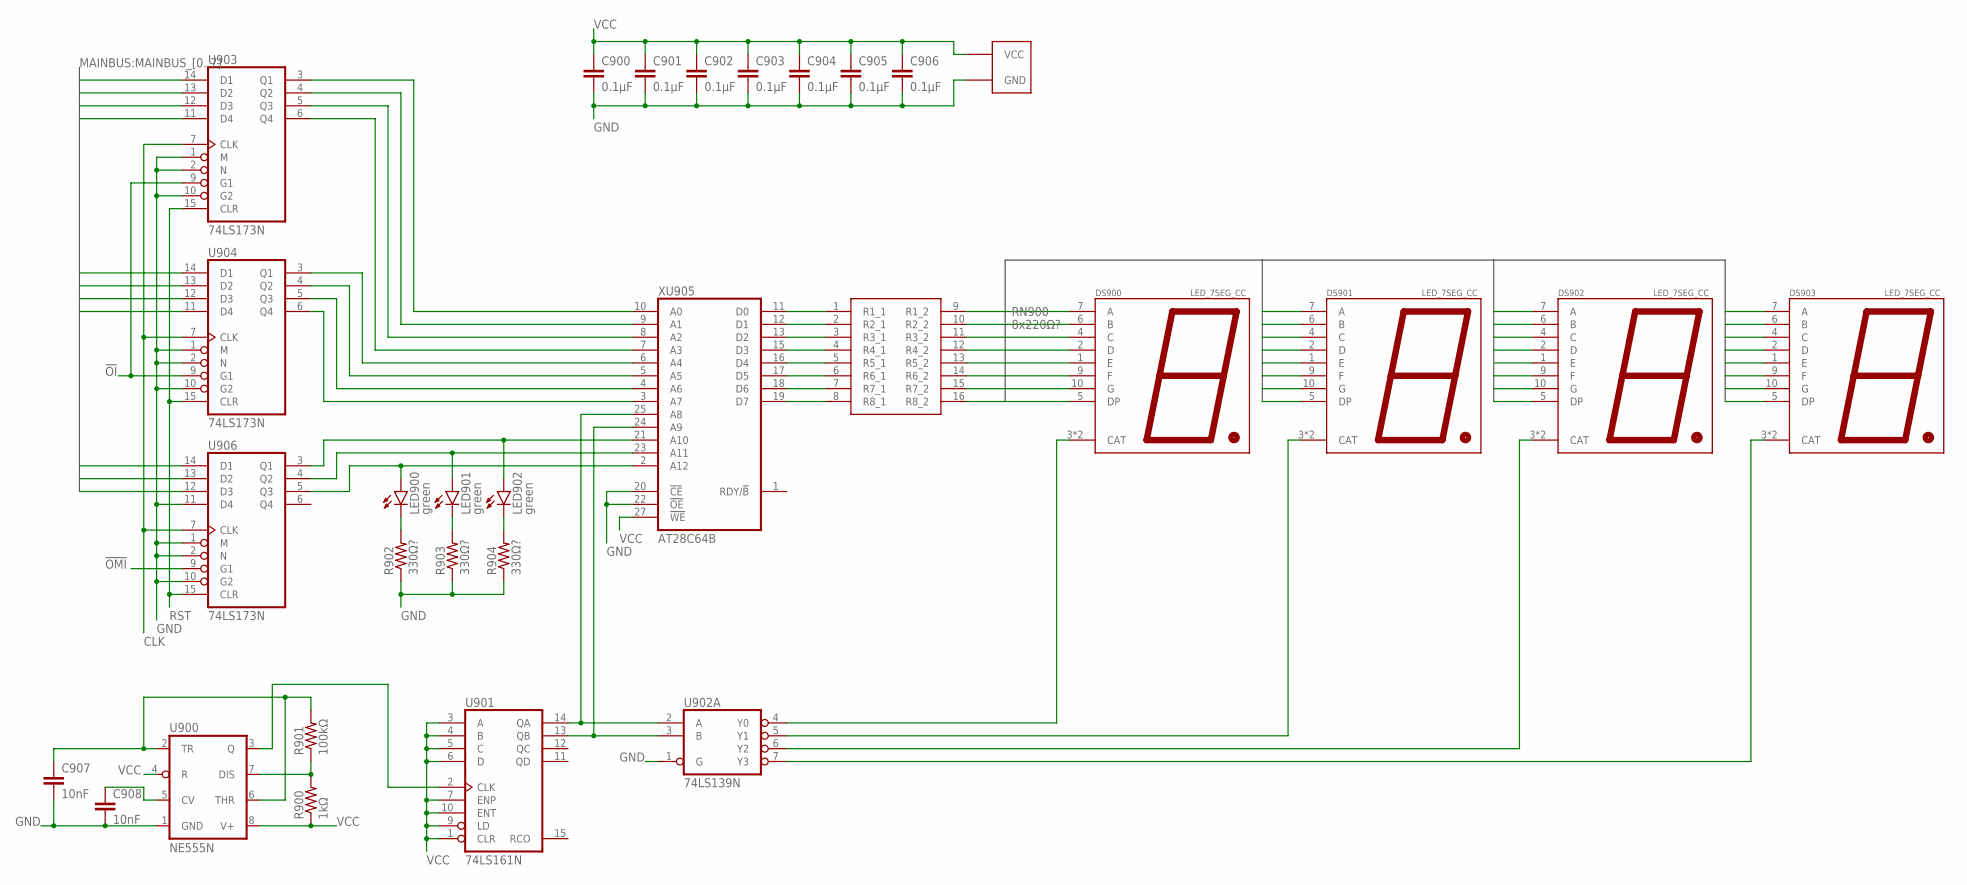
[picture p10: schematic main.sch, sheet 9, Numerical Output]

Parts:
C900, C901, C902, C903, C904, C905, C906: 0.1µF; C0805K
C907, C908: 10nF; C0805K
DS900, DS901, DS902, DS903: LED_7SEG_CC; LED_7SEG
LED900, LED901, LED902: green; LED3MM
R900: 1kΩ; R0805
R901: 100kΩ; R0805
R902, R903, R904: 330Ω?; R0805
RN900: 8x220Ω?; CAY16102J8LF
U900: NE555N; DIL08
U901: 74LS161N; DIL16
U902: 74LS139N; DIL16
U903, U904, U906: 74LS173N; DIL16
XU905: AT28C64B; DIL28

Connections:
!OI: U903.9 (G1), U904.9 (G1); also elsewhere on the board
!OMI: U906.9 (G1); also elsewhere on the board
CLK: U903.7 (CLK), U904.7 (CLK), U906.7 (CLK); also elsewhere on the board
GND: C900.2, C901.2, C902.2, C903.2, C904.2, C905.2, C906.2, C907.2, C908.2, R902.1, R903.1, R904.1, U900.1 (GND), U901.8 (GND), U902.1 (G), U902.8 (GND), U903.1 (M), U903.2 (N), U903.8 (GND), U903.10 (G2), U904.1 (M), U904.2 (N), U904.8 (GND), U904.10 (G2), U906.1 (M), U906.2 (N), U906.8 (GND), U906.10 (G2), U906.11 (D4), XU905.14 (GND), XU905.20 (!CE), XU905.22 (!OE); also elsewhere on the board
LED900_GND: LED900.K (C), R902.2
LED901_GND: LED901.K (C), R903.2
LED902_GND: LED902.K (C), R904.2
MAINBUS_0: U903.14 (D1), U906.14 (D1); also elsewhere on the board
MAINBUS_1: U903.13 (D2), U906.13 (D2); also elsewhere on the board
MAINBUS_2: U903.12 (D3), U906.12 (D3); also elsewhere on the board
MAINBUS_3: U903.11 (D4); also elsewhere on the board
MAINBUS_4: U904.14 (D1); also elsewhere on the board
MAINBUS_5: U904.13 (D2); also elsewhere on the board
MAINBUS_6: U904.12 (D3); also elsewhere on the board
MAINBUS_7: U904.11 (D4); also elsewhere on the board
OUT_CAT_0: DS900.3 (CAT), DS900.8 (CAT), U902.4 (Y0)
OUT_CAT_1: DS901.3 (CAT), DS901.8 (CAT), U902.5 (Y1)
OUT_CAT_2: DS902.3 (CAT), DS902.8 (CAT), U902.6 (Y2)
OUT_CAT_3: DS903.3 (CAT), DS903.8 (CAT), U902.7 (Y3)
OUT_DATA_0: U903.3 (Q1), XU905.10 (A0)
OUT_DATA_1: U903.4 (Q2), XU905.9 (A1)
OUT_DATA_2: U903.5 (Q3), XU905.8 (A2)
OUT_DATA_3: U903.6 (Q4), XU905.7 (A3)
OUT_DATA_4: U904.3 (Q1), XU905.6 (A4)
OUT_DATA_5: U904.4 (Q2), XU905.5 (A5)
OUT_DATA_6: U904.5 (Q3), XU905.4 (A6)
OUT_DATA_7: U904.6 (Q4), XU905.3 (A7)
OUT_MODE_0: LED902.A, U906.3 (Q1), XU905.21 (A10)
OUT_MODE_1: LED901.A, U906.4 (Q2), XU905.23 (A11)
OUT_MODE_2: LED900.A, U906.5 (Q3), XU905.2 (A12)
OUT_MUX_0: U901.14 (QA), U902.2 (A), XU905.25 (A8)
OUT_MUX_1: U901.13 (QB), U902.3 (B), XU905.24 (A9)
OUT_MUX_CLK: U900.3 (Q), U901.2 (CLK)
OUT_SEG_A: DS900.7 (A), DS901.7 (A), DS902.7 (A), DS903.7 (A), RN900.9 (R1_2)
OUT_SEG_A_INT: RN900.1 (R1_1), XU905.11 (D0)
OUT_SEG_B: DS900.6 (B), DS901.6 (B), DS902.6 (B), DS903.6 (B), RN900.10 (R2_2)
OUT_SEG_B_INT: RN900.2 (R2_1), XU905.12 (D1)
OUT_SEG_C: DS900.4 (C), DS901.4 (C), DS902.4 (C), DS903.4 (C), RN900.11 (R3_2)
OUT_SEG_C_INT: RN900.3 (R3_1), XU905.13 (D2)
OUT_SEG_D: DS900.2 (D), DS901.2 (D), DS902.2 (D), DS903.2 (D), RN900.12 (R4_2)
OUT_SEG_DP: DS900.5 (DP), DS901.5 (DP), DS902.5 (DP), DS903.5 (DP), RN900.16 (R8_2)
OUT_SEG_DP_INT: RN900.8 (R8_1), XU905.19 (D7)
OUT_SEG_D_INT: RN900.4 (R4_1), XU905.15 (D3)
OUT_SEG_E: DS900.1 (E), DS901.1 (E), DS902.1 (E), DS903.1 (E), RN900.13 (R5_2)
OUT_SEG_E_INT: RN900.5 (R5_1), XU905.16 (D4)
OUT_SEG_F: DS900.9 (F), DS901.9 (F), DS902.9 (F), DS903.9 (F), RN900.14 (R6_2)
OUT_SEG_F_INT: RN900.6 (R6_1), XU905.17 (D5)
OUT_SEG_G: DS900.10 (G), DS901.10 (G), DS902.10 (G), DS903.10 (G), RN900.15 (R7_2)
OUT_SEG_G_INT: RN900.7 (R7_1), XU905.18 (D6)
RST: U903.15 (CLR), U904.15 (CLR), U906.15 (CLR); also elsewhere on the board
U900_CAP: C907.1, R901.2, U900.2 (TR), U900.6 (THR)
U900_CV: C908.1, U900.5 (CV)
U900_DIS: R900.2, R901.1, U900.7 (DIS)
VCC: C900.1, C901.1, C902.1, C903.1, C904.1, C905.1, C906.1, R900.1, U900.4 (R), U900.8 (V+), U901.1 (CLR), U901.3 (A), U901.4 (B), U901.5 (C), U901.6 (D), U901.7 (ENP), U901.9 (LD), U901.10 (ENT), U901.16 (VCC), U902.16 (VCC), U903.16 (VCC), U904.16 (VCC), U906.16 (VCC), XU905.27 (!WE), XU905.28 (VCC); also elsewhere on the board
