BlockWorker/EE-8BitComputer/main.brd

## EAGLE design main.brd (continued)

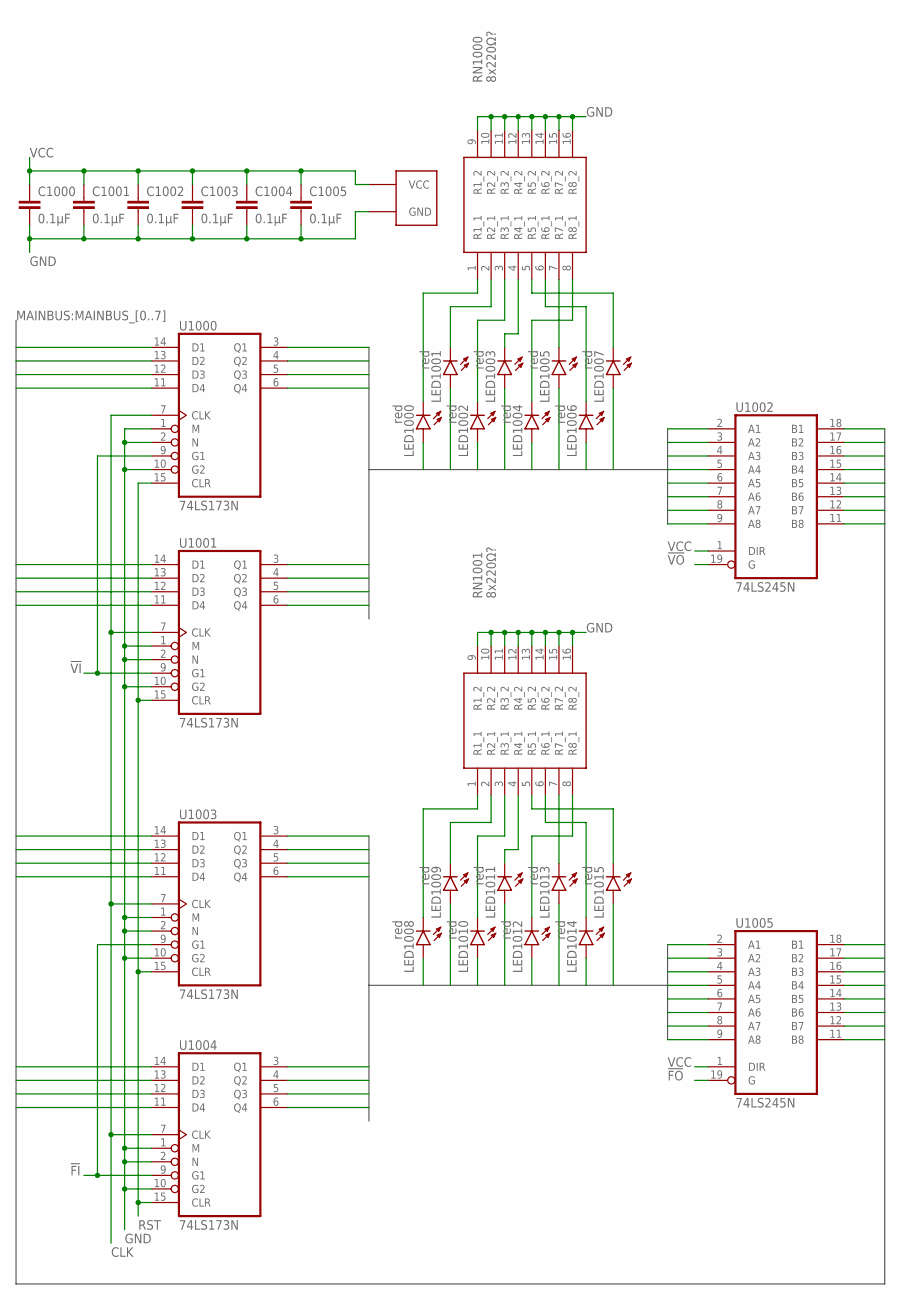
[picture p11: schematic main.sch, sheet 10, V & F Registers]

Parts:
C1000, C1001, C1002, C1003, C1004, C1005: 0.1µF; C0805K
LED1000, LED1001, LED1002, LED1003, LED1004, LED1005, LED1006, LED1007, LED1008, LED1009, LED1010, LED1011, LED1012, LED1013, LED1014, LED1015: red; LED3MM
RN1000, RN1001: 8x220Ω?; CAY16102J8LF
U1000, U1001, U1003, U1004: 74LS173N; DIL16
U1002, U1005: 74LS245N; DIL20

Connections:
!FI: U1003.9 (G1), U1004.9 (G1); also elsewhere on the board
!FO: U1005.19 (G); also elsewhere on the board
!VI: U1000.9 (G1), U1001.9 (G1); also elsewhere on the board
!VO: U1002.19 (G); also elsewhere on the board
CLK: U1000.7 (CLK), U1001.7 (CLK), U1003.7 (CLK), U1004.7 (CLK); also elsewhere on the board
GND: C1000.2, C1001.2, C1002.2, C1003.2, C1004.2, C1005.2, RN1000.9 (R1_2), RN1000.10 (R2_2), RN1000.11 (R3_2), RN1000.12 (R4_2), RN1000.13 (R5_2), RN1000.14 (R6_2), RN1000.15 (R7_2), RN1000.16 (R8_2), RN1001.9 (R1_2), RN1001.10 (R2_2), RN1001.11 (R3_2), RN1001.12 (R4_2), RN1001.13 (R5_2), RN1001.14 (R6_2), RN1001.15 (R7_2), RN1001.16 (R8_2), U1000.1 (M), U1000.2 (N), U1000.8 (GND), U1000.10 (G2), U1001.1 (M), U1001.2 (N), U1001.8 (GND), U1001.10 (G2), U1002.10 (GND), U1003.1 (M), U1003.2 (N), U1003.8 (GND), U1003.10 (G2), U1004.1 (M), U1004.2 (N), U1004.8 (GND), U1004.10 (G2), U1005.10 (GND); also elsewhere on the board
LED1000_GND: LED1000.K (C), RN1000.1 (R1_1)
LED1001_GND: LED1001.K (C), RN1000.2 (R2_1)
LED1002_GND: LED1002.K (C), RN1000.3 (R3_1)
LED1003_GND: LED1003.K (C), RN1000.4 (R4_1)
LED1004_GND: LED1004.K (C), RN1000.8 (R8_1)
LED1005_GND: LED1005.K (C), RN1000.7 (R7_1)
LED1006_GND: LED1006.K (C), RN1000.6 (R6_1)
LED1007_GND: LED1007.K (C), RN1000.5 (R5_1)
LED1008_GND: LED1008.K (C), RN1001.1 (R1_1)
LED1009_GND: LED1009.K (C), RN1001.2 (R2_1)
LED1010_GND: LED1010.K (C), RN1001.3 (R3_1)
LED1011_GND: LED1011.K (C), RN1001.4 (R4_1)
LED1012_GND: LED1012.K (C), RN1001.8 (R8_1)
LED1013_GND: LED1013.K (C), RN1001.7 (R7_1)
LED1014_GND: LED1014.K (C), RN1001.6 (R6_1)
LED1015_GND: LED1015.K (C), RN1001.5 (R5_1)
MAINBUS_0: U1001.11 (D4), U1002.11 (B8), U1004.11 (D4), U1005.11 (B8); also elsewhere on the board
MAINBUS_1: U1001.12 (D3), U1002.12 (B7), U1004.12 (D3), U1005.12 (B7); also elsewhere on the board
MAINBUS_2: U1001.13 (D2), U1002.13 (B6), U1004.13 (D2), U1005.13 (B6); also elsewhere on the board
MAINBUS_3: U1001.14 (D1), U1002.14 (B5), U1004.14 (D1), U1005.14 (B5); also elsewhere on the board
MAINBUS_4: U1000.11 (D4), U1002.15 (B4), U1003.11 (D4), U1005.15 (B4); also elsewhere on the board
MAINBUS_5: U1000.12 (D3), U1002.16 (B3), U1003.12 (D3), U1005.16 (B3); also elsewhere on the board
MAINBUS_6: U1000.13 (D2), U1002.17 (B2), U1003.13 (D2), U1005.17 (B2); also elsewhere on the board
MAINBUS_7: U1000.14 (D1), U1002.18 (B1), U1003.14 (D1), U1005.18 (B1); also elsewhere on the board
REG_F_0: LED1015.A, U1004.6 (Q4), U1005.9 (A8)
REG_F_1: LED1014.A, U1004.5 (Q3), U1005.8 (A7)
REG_F_2: LED1013.A, U1004.4 (Q2), U1005.7 (A6)
REG_F_3: LED1012.A, U1004.3 (Q1), U1005.6 (A5)
REG_F_4: LED1011.A, U1003.6 (Q4), U1005.5 (A4)
REG_F_5: LED1010.A, U1003.5 (Q3), U1005.4 (A3)
REG_F_6: LED1009.A, U1003.4 (Q2), U1005.3 (A2)
REG_F_7: LED1008.A, U1003.3 (Q1), U1005.2 (A1)
REG_V_0: LED1007.A, U1001.6 (Q4), U1002.9 (A8)
REG_V_1: LED1006.A, U1001.5 (Q3), U1002.8 (A7)
REG_V_2: LED1005.A, U1001.4 (Q2), U1002.7 (A6)
REG_V_3: LED1004.A, U1001.3 (Q1), U1002.6 (A5)
REG_V_4: LED1003.A, U1000.6 (Q4), U1002.5 (A4)
REG_V_5: LED1002.A, U1000.5 (Q3), U1002.4 (A3)
REG_V_6: LED1001.A, U1000.4 (Q2), U1002.3 (A2)
REG_V_7: LED1000.A, U1000.3 (Q1), U1002.2 (A1)
RST: U1000.15 (CLR), U1001.15 (CLR), U1003.15 (CLR), U1004.15 (CLR); also elsewhere on the board
VCC: C1000.1, C1001.1, C1002.1, C1003.1, C1004.1, C1005.1, U1000.16 (VCC), U1001.16 (VCC), U1002.1 (DIR), U1002.20 (VCC), U1003.16 (VCC), U1004.16 (VCC), U1005.1 (DIR), U1005.20 (VCC); also elsewhere on the board

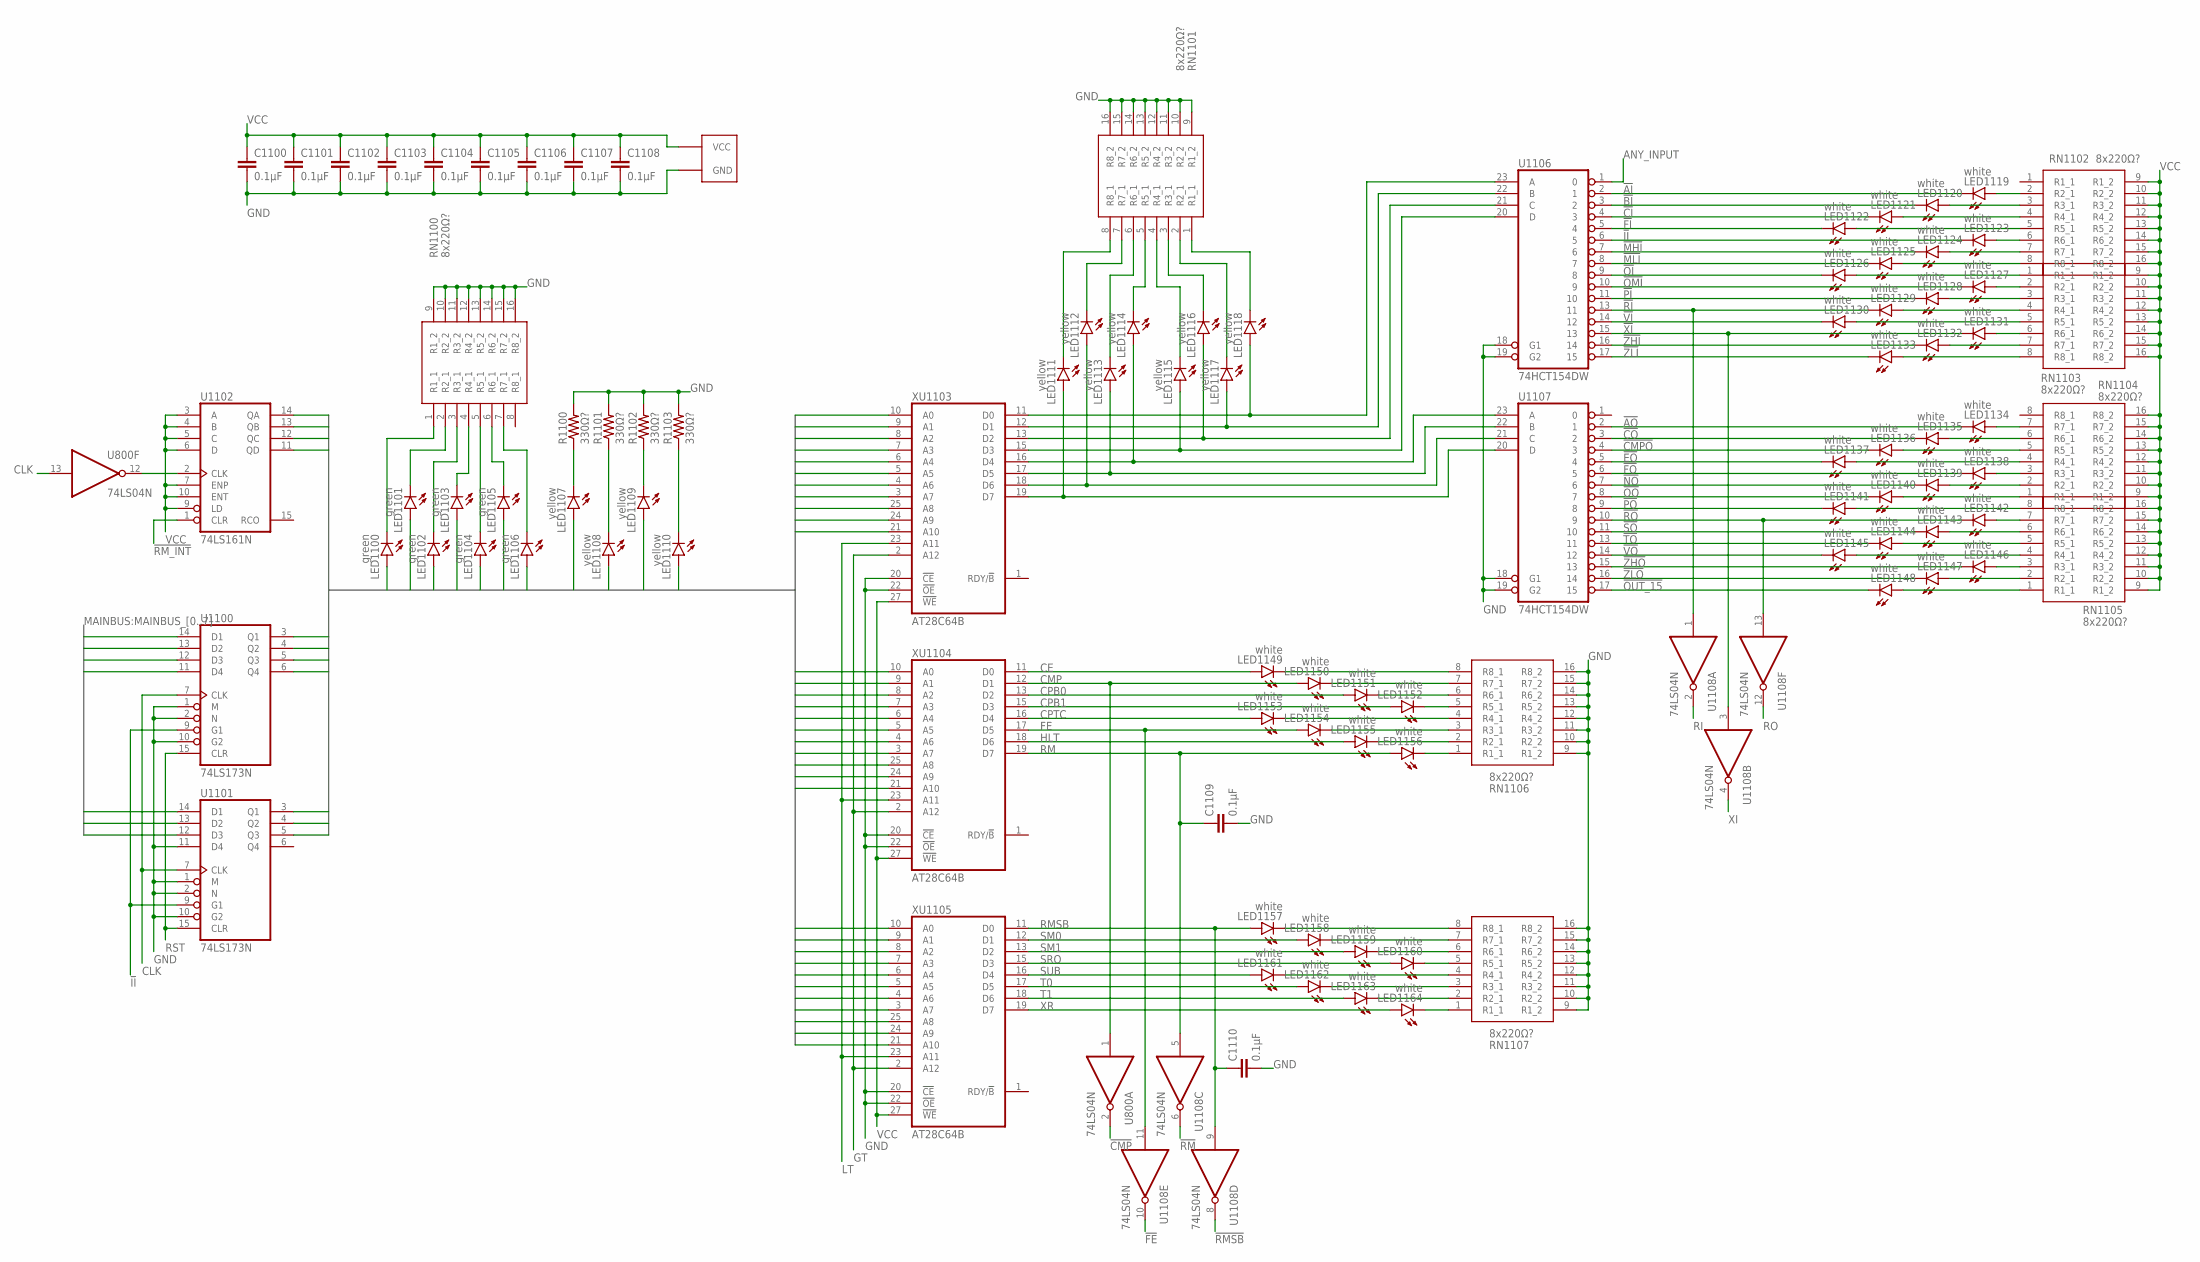
[picture p12: schematic main.sch, sheet 11, Instruction Control]

Parts:
C1100, C1101, C1102, C1103, C1104, C1105, C1106, C1107, C1108, C1109, C1110: 0.1µF; C0805K
LED1100, LED1101, LED1102, LED1103, LED1104, LED1105, LED1106: green; LED3MM
LED1107, LED1108, LED1109, LED1110, LED1111, LED1112, LED1113, LED1114, LED1115, LED1116, LED1117, LED1118: yellow; LED3MM
LED1119, LED1120, LED1121, LED1122, LED1123, LED1124, LED1125, LED1126, LED1127, LED1128, LED1129, LED1130, LED1131, LED1132, LED1133, LED1134, LED1135, LED1136, LED1137, LED1138, LED1139, LED1140, LED1141, LED1142, LED1143, LED1144, LED1145, LED1146, LED1147, LED1148, LED1149, LED1150, LED1151, LED1152, LED1153, LED1154, LED1155, LED1156, LED1157, LED1158, LED1159, LED1160, LED1161, LED1162, LED1163, LED1164: white; LED3MM
R1100, R1101, R1102, R1103: 330Ω?; R0805
RN1100, RN1101, RN1102, RN1103, RN1104, RN1105, RN1106, RN1107: 8x220Ω?; CAY16102J8LF
U800, U1108: 74LS04N; DIL14
U1100, U1101: 74LS173N; DIL16
U1102: 74LS161N; DIL16
U1106, U1107: 74HCT154DW; SO24W
XU1103, XU1104, XU1105: AT28C64B; DIL28

Connections:
!AI: LED1119.K (C), U1106.2 (1); also elsewhere on the board
!AO: LED1134.K (C), U1107.2 (1); also elsewhere on the board
!BI: LED1120.K (C), U1106.3 (2); also elsewhere on the board
!CI: LED1121.K (C), U1106.4 (3); also elsewhere on the board
!CLK: U800.12 (O), U1102.2 (CLK)
!CMP: U800.2 (O); also elsewhere on the board
!CMPO: LED1136.K (C), U1107.4 (3); also elsewhere on the board
!CO: LED1135.K (C), U1107.3 (2); also elsewhere on the board
!EO: LED1137.K (C), U1107.5 (4); also elsewhere on the board
!FE: U1108.10 (O); also elsewhere on the board
!FI: LED1122.K (C), U1106.5 (4); also elsewhere on the board
!FO: LED1138.K (C), U1107.6 (5); also elsewhere on the board
!II: LED1123.K (C), U1100.9 (G1), U1101.9 (G1), U1106.6 (5)
!MHI: LED1124.K (C), U1106.7 (6); also elsewhere on the board
!MLI: LED1125.K (C), U1106.8 (7); also elsewhere on the board
!NO: LED1139.K (C), U1107.7 (6); also elsewhere on the board
!OI: LED1126.K (C), U1106.9 (8); also elsewhere on the board
!OMI: LED1127.K (C), U1106.10 (9); also elsewhere on the board
!OO: LED1140.K (C), U1107.8 (7); also elsewhere on the board
!OUT_15: LED1148.K (C), U1107.17 (15)
!PI: LED1128.K (C), U1106.11 (10); also elsewhere on the board
!PO: LED1141.K (C), U1107.9 (8); also elsewhere on the board
!RI: LED1129.K (C), U1106.13 (11), U1108.1 (I)
!RM: U1108.6 (O); also elsewhere on the board
!RMSB: U1108.8 (O); also elsewhere on the board
!RM_INT: U1102.1 (CLR); also elsewhere on the board
!RO: LED1142.K (C), U1107.10 (9), U1108.13 (I)
!SO: LED1143.K (C), U1107.11 (10); also elsewhere on the board
!TO: LED1144.K (C), U1107.13 (11); also elsewhere on the board
!VI: LED1130.K (C), U1106.14 (12); also elsewhere on the board
!VO: LED1145.K (C), U1107.14 (12); also elsewhere on the board
!XI: LED1131.K (C), U1106.15 (13), U1108.3 (I)
!ZHI: LED1132.K (C), U1106.16 (14); also elsewhere on the board
!ZHO: LED1146.K (C), U1107.15 (13); also elsewhere on the board
!ZLI: LED1133.K (C), U1106.17 (15); also elsewhere on the board
!ZLO: LED1147.K (C), U1107.16 (14); also elsewhere on the board
ANY_INPUT: U1106.1 (0); also elsewhere on the board
CE: LED1149.A, XU1104.11 (D0); also elsewhere on the board
CLK: U800.13 (I), U1100.7 (CLK), U1101.7 (CLK); also elsewhere on the board
CMP: LED1150.A, U800.1 (I), XU1104.12 (D1)
CPB0: LED1151.A, XU1104.13 (D2); also elsewhere on the board
CPB1: LED1152.A, XU1104.15 (D3); also elsewhere on the board
CPTC: LED1153.A, XU1104.16 (D4); also elsewhere on the board
FE: LED1154.A, U1108.11 (I), XU1104.17 (D5)
GND: C1100.2, C1101.2, C1102.2, C1103.2, C1104.2, C1105.2, C1106.2, C1107.2, C1108.2, C1109.2, C1110.2, R1100.2, R1101.2, R1102.2, R1103.2, RN1100.9 (R1_2), RN1100.10 (R2_2), RN1100.11 (R3_2), RN1100.12 (R4_2), RN1100.13 (R5_2), RN1100.14 (R6_2), RN1100.15 (R7_2), RN1100.16 (R8_2), RN1101.9 (R1_2), RN1101.10 (R2_2), RN1101.11 (R3_2), RN1101.12 (R4_2), RN1101.13 (R5_2), RN1101.14 (R6_2), RN1101.15 (R7_2), RN1101.16 (R8_2), RN1106.9 (R1_2), RN1106.10 (R2_2), RN1106.11 (R3_2), RN1106.12 (R4_2), RN1106.13 (R5_2), RN1106.14 (R6_2), RN1106.15 (R7_2), RN1106.16 (R8_2), RN1107.9 (R1_2), RN1107.10 (R2_2), RN1107.11 (R3_2), RN1107.12 (R4_2), RN1107.13 (R5_2), RN1107.14 (R6_2), RN1107.15 (R7_2), RN1107.16 (R8_2), U800.7 (GND), U1100.1 (M), U1100.2 (N), U1100.8 (GND), U1100.10 (G2), U1101.1 (M), U1101.2 (N), U1101.8 (GND), U1101.10 (G2), U1101.11 (D4), U1102.8 (GND), U1106.12 (GND), U1106.18 (G1), U1106.19 (G2), U1107.12 (GND), U1107.18 (G1), U1107.19 (G2), U1108.7 (GND), XU1103.14 (GND), XU1103.20 (!CE), XU1103.22 (!OE), XU1104.14 (GND), XU1104.20 (!CE), XU1104.22 (!OE), XU1105.14 (GND), XU1105.20 (!CE), XU1105.22 (!OE); also elsewhere on the board
GT: XU1103.2 (A12), XU1104.2 (A12), XU1105.2 (A12); also elsewhere on the board
HLT: LED1155.A, XU1104.18 (D6); also elsewhere on the board
INT_INSTR_I_0: LED1106.A, U1100.3 (Q1), XU1103.6 (A4), XU1104.6 (A4), XU1105.6 (A4)
INT_INSTR_I_1: LED1105.A, U1100.4 (Q2), XU1103.5 (A5), XU1104.5 (A5), XU1105.5 (A5)
INT_INSTR_I_2: LED1104.A, U1100.5 (Q3), XU1103.4 (A6), XU1104.4 (A6), XU1105.4 (A6)
INT_INSTR_I_3: LED1103.A, U1100.6 (Q4), XU1103.3 (A7), XU1104.3 (A7), XU1105.3 (A7)
INT_INSTR_I_4: LED1102.A, U1101.3 (Q1), XU1103.25 (A8), XU1104.25 (A8), XU1105.25 (A8)
INT_INSTR_I_5: LED1101.A, U1101.4 (Q2), XU1103.24 (A9), XU1104.24 (A9), XU1105.24 (A9)
INT_INSTR_I_6: LED1100.A, U1101.5 (Q3), XU1103.21 (A10), XU1104.21 (A10), XU1105.21 (A10)
INT_INSTR_M_0: LED1110.A, U1102.14 (QA), XU1103.10 (A0), XU1104.10 (A0), XU1105.10 (A0)
INT_INSTR_M_1: LED1109.A, U1102.13 (QB), XU1103.9 (A1), XU1104.9 (A1), XU1105.9 (A1)
INT_INSTR_M_2: LED1108.A, U1102.12 (QC), XU1103.8 (A2), XU1104.8 (A2), XU1105.8 (A2)
INT_INSTR_M_3: LED1107.A, U1102.11 (QD), XU1103.7 (A3), XU1104.7 (A3), XU1105.7 (A3)
IN_INDEX_0: LED1118.A, U1106.23 (A), XU1103.11 (D0)
IN_INDEX_1: LED1117.A, U1106.22 (B), XU1103.12 (D1)
IN_INDEX_2: LED1116.A, U1106.21 (C), XU1103.13 (D2)
IN_INDEX_3: LED1115.A, U1106.20 (D), XU1103.15 (D3)
LED1100_GND: LED1100.K (C), RN1100.1 (R1_1)
LED1101_GND: LED1101.K (C), RN1100.2 (R2_1)
LED1102_GND: LED1102.K (C), RN1100.3 (R3_1)
LED1103_GND: LED1103.K (C), RN1100.4 (R4_1)
LED1104_GND: LED1104.K (C), RN1100.5 (R5_1)
LED1105_GND: LED1105.K (C), RN1100.6 (R6_1)
LED1106_GND: LED1106.K (C), RN1100.7 (R7_1)
LED1107_GND: LED1107.K (C), R1100.1
LED1108_GND: LED1108.K (C), R1101.1
LED1109_GND: LED1109.K (C), R1102.1
LED1110_GND: LED1110.K (C), R1103.1
LED1111_GND: LED1111.K (C), RN1101.8 (R8_1)
LED1112_GND: LED1112.K (C), RN1101.7 (R7_1)
LED1113_GND: LED1113.K (C), RN1101.6 (R6_1)
LED1114_GND: LED1114.K (C), RN1101.5 (R5_1)
LED1115_GND: LED1115.K (C), RN1101.4 (R4_1)
LED1116_GND: LED1116.K (C), RN1101.3 (R3_1)
LED1117_GND: LED1117.K (C), RN1101.2 (R2_1)
LED1118_GND: LED1118.K (C), RN1101.1 (R1_1)
LED1119_VCC: LED1119.A, RN1102.2 (R2_1)
LED1120_VCC: LED1120.A, RN1102.3 (R3_1)
LED1121_VCC: LED1121.A, RN1102.4 (R4_1)
LED1122_VCC: LED1122.A, RN1102.5 (R5_1)
LED1123_VCC: LED1123.A, RN1102.6 (R6_1)
LED1124_VCC: LED1124.A, RN1102.7 (R7_1)
LED1125_VCC: LED1125.A, RN1102.8 (R8_1)
LED1126_VCC: LED1126.A, RN1103.1 (R1_1)
LED1127_VCC: LED1127.A, RN1103.2 (R2_1)
LED1128_VCC: LED1128.A, RN1103.3 (R3_1)
LED1129_VCC: LED1129.A, RN1103.4 (R4_1)
LED1130_VCC: LED1130.A, RN1103.5 (R5_1)
LED1131_VCC: LED1131.A, RN1103.6 (R6_1)
LED1132_VCC: LED1132.A, RN1103.7 (R7_1)
LED1133_VCC: LED1133.A, RN1103.8 (R8_1)
LED1134_VCC: LED1134.A, RN1104.7 (R7_1)
LED1135_VCC: LED1135.A, RN1104.6 (R6_1)
LED1136_VCC: LED1136.A, RN1104.5 (R5_1)
LED1137_VCC: LED1137.A, RN1104.4 (R4_1)
LED1138_VCC: LED1138.A, RN1104.3 (R3_1)
LED1139_VCC: LED1139.A, RN1104.2 (R2_1)
LED1140_VCC: LED1140.A, RN1104.1 (R1_1)
LED1141_VCC: LED1141.A, RN1105.8 (R8_1)
LED1142_VCC: LED1142.A, RN1105.7 (R7_1)
LED1143_VCC: LED1143.A, RN1105.6 (R6_1)
LED1144_VCC: LED1144.A, RN1105.5 (R5_1)
LED1145_VCC: LED1145.A, RN1105.4 (R4_1)
LED1146_VCC: LED1146.A, RN1105.3 (R3_1)
LED1147_VCC: LED1147.A, RN1105.2 (R2_1)
LED1148_VCC: LED1148.A, RN1105.1 (R1_1)
LED1149_GND: LED1149.K (C), RN1106.8 (R8_1)
LED1150_GND: LED1150.K (C), RN1106.7 (R7_1)
LED1151_GND: LED1151.K (C), RN1106.6 (R6_1)
LED1152_GND: LED1152.K (C), RN1106.5 (R5_1)
LED1153_GND: LED1153.K (C), RN1106.4 (R4_1)
LED1154_GND: LED1154.K (C), RN1106.3 (R3_1)
LED1155_GND: LED1155.K (C), RN1106.2 (R2_1)
LED1156_GND: LED1156.K (C), RN1106.1 (R1_1)
LED1157_GND: LED1157.K (C), RN1107.8 (R8_1)
LED1158_GND: LED1158.K (C), RN1107.7 (R7_1)
LED1159_GND: LED1159.K (C), RN1107.6 (R6_1)
LED1160_GND: LED1160.K (C), RN1107.5 (R5_1)
LED1161_GND: LED1161.K (C), RN1107.4 (R4_1)
LED1162_GND: LED1162.K (C), RN1107.3 (R3_1)
LED1163_GND: LED1163.K (C), RN1107.2 (R2_1)
LED1164_GND: LED1164.K (C), RN1107.1 (R1_1)
LT: XU1103.23 (A11), XU1104.23 (A11), XU1105.23 (A11); also elsewhere on the board
MAINBUS_0: U1100.14 (D1); also elsewhere on the board
MAINBUS_1: U1100.13 (D2); also elsewhere on the board
MAINBUS_2: U1100.12 (D3); also elsewhere on the board
MAINBUS_3: U1100.11 (D4); also elsewhere on the board
MAINBUS_4: U1101.14 (D1); also elsewhere on the board
MAINBUS_5: U1101.13 (D2); also elsewhere on the board
MAINBUS_6: U1101.12 (D3); also elsewhere on the board
OUT_INDEX_0: LED1114.A, U1107.23 (A), XU1103.16 (D4)
OUT_INDEX_1: LED1113.A, U1107.22 (B), XU1103.17 (D5)
OUT_INDEX_2: LED1112.A, U1107.21 (C), XU1103.18 (D6)
OUT_INDEX_3: LED1111.A, U1107.20 (D), XU1103.19 (D7)
RI: U1108.2 (O); also elsewhere on the board
RM: C1109.1, LED1156.A, U1108.5 (I), XU1104.19 (D7)
RMSB: C1110.1, LED1157.A, U1108.9 (I), XU1105.11 (D0)
RO: U1108.12 (O); also elsewhere on the board
RST: U1100.15 (CLR), U1101.15 (CLR); also elsewhere on the board
SM0: LED1158.A, XU1105.12 (D1); also elsewhere on the board
SM1: LED1159.A, XU1105.13 (D2); also elsewhere on the board
SRO: LED1160.A, XU1105.15 (D3); also elsewhere on the board
SUB: LED1161.A, XU1105.16 (D4); also elsewhere on the board
T0: LED1162.A, XU1105.17 (D5); also elsewhere on the board
T1: LED1163.A, XU1105.18 (D6); also elsewhere on the board
VCC: C1100.1, C1101.1, C1102.1, C1103.1, C1104.1, C1105.1, C1106.1, C1107.1, C1108.1, RN1102.9 (R1_2), RN1102.10 (R2_2), RN1102.11 (R3_2), RN1102.12 (R4_2), RN1102.13 (R5_2), RN1102.14 (R6_2), RN1102.15 (R7_2), RN1102.16 (R8_2), RN1103.9 (R1_2), RN1103.10 (R2_2), RN1103.11 (R3_2), RN1103.12 (R4_2), RN1103.13 (R5_2), RN1103.14 (R6_2), RN1103.15 (R7_2), RN1103.16 (R8_2), RN1104.9 (R1_2), RN1104.10 (R2_2), RN1104.11 (R3_2), RN1104.12 (R4_2), RN1104.13 (R5_2), RN1104.14 (R6_2), RN1104.15 (R7_2), RN1104.16 (R8_2), RN1105.9 (R1_2), RN1105.10 (R2_2), RN1105.11 (R3_2), RN1105.12 (R4_2), RN1105.13 (R5_2), RN1105.14 (R6_2), RN1105.15 (R7_2), RN1105.16 (R8_2), U800.14 (VCC), U1100.16 (VCC), U1101.16 (VCC), U1102.3 (A), U1102.4 (B), U1102.5 (C), U1102.6 (D), U1102.7 (ENP), U1102.9 (LD), U1102.10 (ENT), U1102.16 (VCC), U1106.24 (VCC), U1107.24 (VCC), U1108.14 (VCC), XU1103.27 (!WE), XU1103.28 (VCC), XU1104.27 (!WE), XU1104.28 (VCC), XU1105.27 (!WE), XU1105.28 (VCC); also elsewhere on the board
XI: U1108.4 (O); also elsewhere on the board
XR: LED1164.A, XU1105.19 (D7); also elsewhere on the board

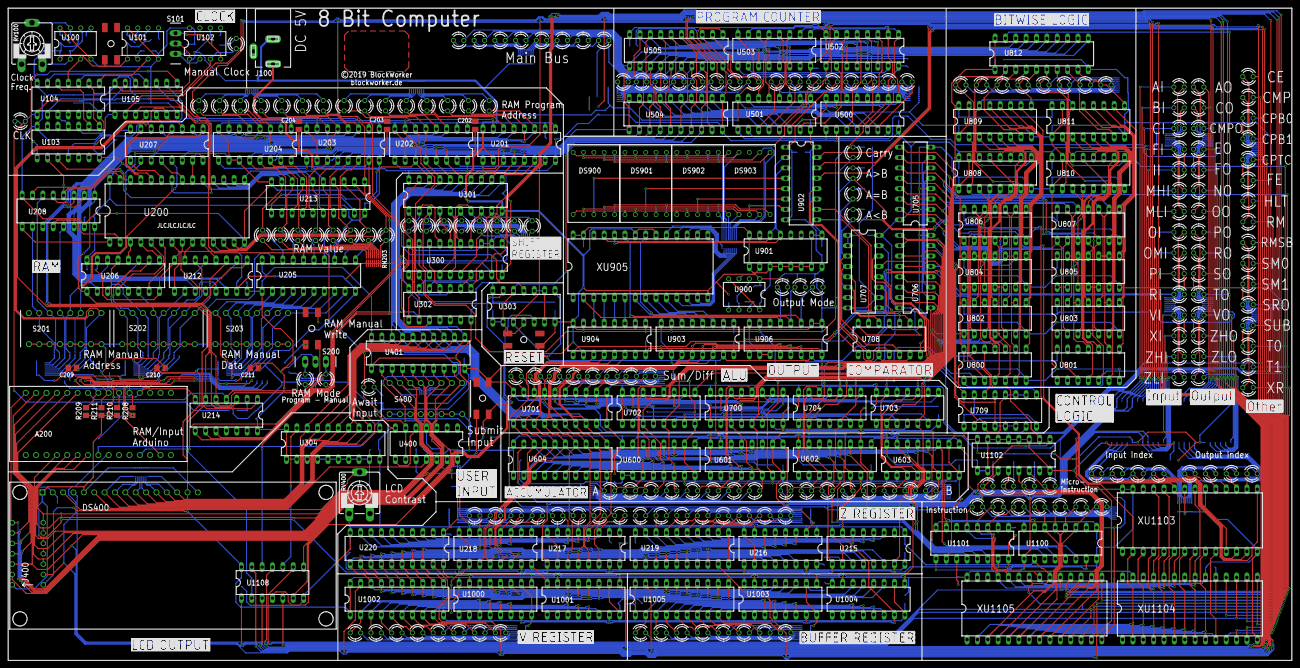
[picture p13: board main.brd from above]

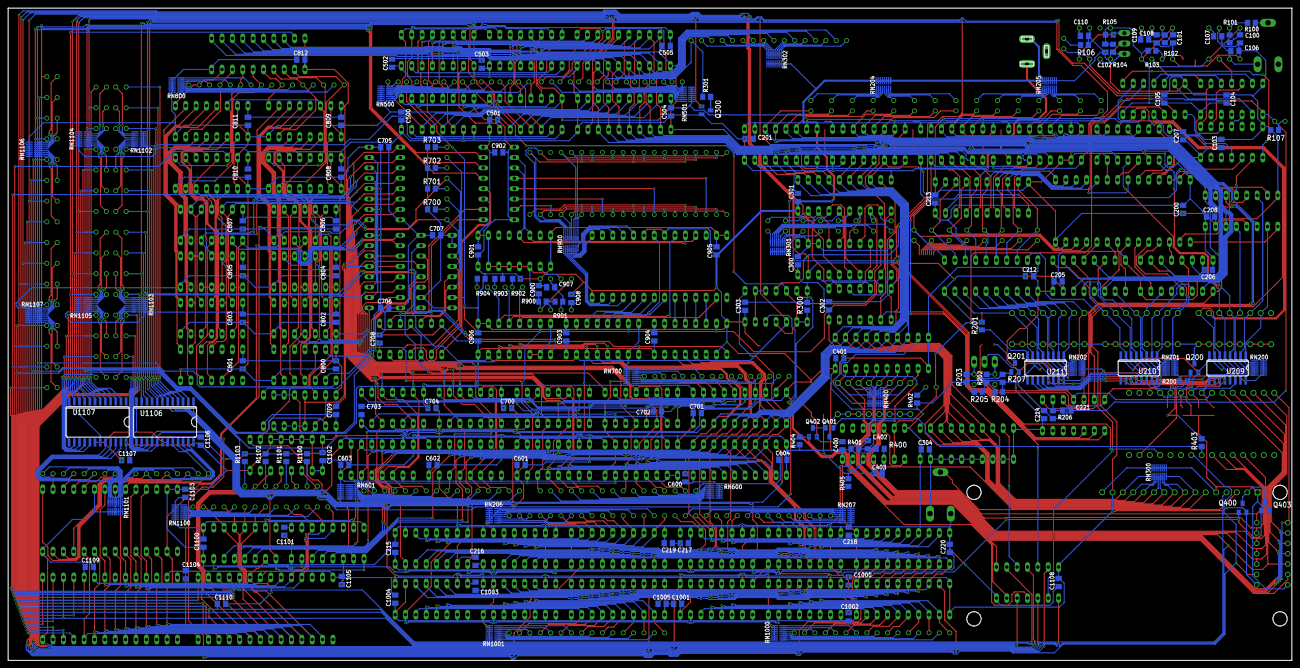
[picture p14: board main.brd from below]

Board: 2 copper layers, 314.5 x 159.8 mm, 485 parts (173 on the bottom side), 600 nets.
