BlockWorker/EE-8BitComputer/(commit log)

2019-04-10 Moved ResNet to included library.
    [main.brd, main.sch]
2019-04-11 Some work on OUT module.
    [main.brd]
2019-04-24 Finished OUT module.
    [main.brd]
2019-04-24 CMP Beginnings
    [main.brd]
2019-04-24 Arranged modules, some bus connections.
    [main.brd]
2019-04-24 Most inter-module connections done, added RESET.
    [main.brd, main.sch]
2019-04-24 Eagle 9.4.0 update.
    [main.brd]
2019-04-25 Z register mostly done.
    [main.brd, main.sch]
2019-04-26 Finished Z, V and F registers.
    [main.brd, main.sch]
2019-04-26 Cleanup and routing of all non-CTRL signals.
    [main.brd]
2019-05-05 Routing and layout done.
    [main.brd, main.sch]
2019-05-05 Revised external input, progress on silkscreen.
    [main.brd, main.sch]
2019-05-05 Progress on silkscreen.
    [main.brd]
2019-05-05 NegaSilk labels added.
    [main.brd]
2019-05-06 Final design with gerber files.
    [main.brd]
2019-10-09 Fixed issues encountered during build and testing.
    [main.brd, main.sch]
2019-10-09 Moved library over to central BW lib, added gitignore
    [main.brd, main.sch]
