BlockWorker/EE-8BitComputer/(notices)

Notices in the files:
main.brd:
©2019 BlockWorker
